Vygis1/sister/docs/ROADMAP.md

# Roadmap

What works, what doesn't yet, and what comes next, system by system. The history of how it got
here is in [CHANGELOG.md](../CHANGELOG.md).

Legend: ✅ done · 🔧 in progress · ⬜ planned

## Systems

### Nintendo 64
- ✅ Super Mario 64, Mario Kart 64 and Super Smash Bros. play
- ✅ Saves (EEPROM) on the SD card; the VI's filters selectable in the menu
- ✅ Every RDP mode the reference model has, YUV textures included
- ⬜ Full speed in every scene (the RSP and RDP's throughput)

### PlayStation
- ✅ Real BIOS, disc images, memory cards, CD audio, XA streaming, MDEC movies
- ✅ Commercial games at their own frame rates (Crash Bandicoot, Syphon Filter, Tekken 2, ...)
- ⬜ High-resolution (480i) menus, such as Gran Turismo 2's
- ⬜ The remaining ps1-tests that DuckStation passes

### DOS PC
- 🔧 Our own 486 and chipset (the first PC, on third-party ao486, was removed 2026-10-23); the bar: DOS, Doom, Rayman, TTD, Fallout
- ✅ SVGA, Sound Blaster 16 + OPL3, ATAPI CD-ROM with CD audio, mouse from the controller
- ✅ A game is one command away: `tools/pc/addgame.py`
- ⬜ A faster CPU clock (Doom's demo3 runs at 17.8 fps)

### Super Nintendo
- ✅ LoROM and HiROM up to 6 MB, save RAM on the SD card
- ⬜ Enhancement chips: DSP-1, Super FX, SA-1
- ⬜ Hi-res modes at their full 512 pixels

### Game Boy / Game Boy Color
- ✅ Both models, MBC1/3/5; cgb-acid2 pixel-exact on the board
- ✅ Battery saves on the SD card: MBC1/3/5 RAM and the MBC3 clock

### Game Boy Advance
- ✅ Pokémon Emerald with its clock; the open BIOS built in
- ✅ Saves on the SD card: SRAM, 64/128 kB flash, 512 B/8 kB EEPROM (jsmolka's save tests pass on the board)
- ⬜ OBJ mosaic, prefetch accuracy

### PC Engine
- ✅ HuCards, multitap
- ⬜ CD-ROM²

### NES · Master System · Game Gear · Mega Drive · Atari 2600
- ✅ Playable; see [CONSOLES.md](CONSOLES.md) for mapper and cartridge coverage
- ⬜ NES: more mappers (CNROM, AxROM, VRC, MMC5)

## The console

- ✅ Graphical menu composed by the FPGA, Bluetooth controllers, settings, saves on the card
- ✅ Every system checked by picture on the board (`tools/coreshots.py`)
- ✅ Two systems kept in the flash at once; switching between them takes a few seconds
- ⬜ HDMI with true differential pairs (some TVs reject the current pseudo-differential signal)

## The project

- ⬜ Release packages for every system: FPGA images and ESP32 firmware, with notices for
  third-party parts (`tools/release.sh` packages the shell, NES, Master System, Mega Drive,
  PlayStation and N64 so far)
