Vygis1/sister/docs/THIRD_PARTY.md

# Third-party components

This project is licensed under the GNU General Public License v3 ([LICENSE](../LICENSE)). The
components below come from other projects and keep their own licences, which are compatible
with it. Their original copyright notices are kept in the files.

## Other cores and tools

| Component | Where | Authors | Licence |
|---|---|---|---|
| Cult-of-GBA BIOS | `rtl/gba_bios_data.vh` | DenSinH, fleroviux | MIT ([LICENSE-gba-bios](../rtl/LICENSE-gba-bios)) |
| parallel-RDP blender tables | `rtl/n64_rdp_blut.v`, `tools/n64/n64rdp.py` | Hans-Kristian Arntzen (Themaister) | MIT |
| QR code generator | `esp32/console/qrgen.c` | Richard Moore, after Project Nayuki | MIT |
| CD-ROM drive emulation for the PC (ported) | `esp32/console/cdrom.h` | MiSTer-devel, Alexey Melnikov | GPL-3.0 |
| Nunito font (rendered) | `tools/menu/fonts/`, `esp32/console/gfx_font.h` | The Nunito Project Authors | OFL-1.1 |
| font8x8 | `rtl/osd_font.v` | Daniel Hepper | Public domain |

## Used at build time, not included

| Component | Used for | Licence |
|---|---|---|
| ESP-IDF Bluedroid, `esp_hid`, the ESP32 Bluetooth controller library | Bluetooth controllers (`pads_bluedroid.h`, docs/BLUETOOTH.md) | Apache-2.0 |
| arduino-esp32, ESP-IDF | ESP32 firmware | LGPL-2.1, Apache-2.0 |
| Xilinx MIG | DDR3 controller, generated by `tools/mig.tcl` | Xilinx licence |
| FreeDOS, HimemX, CuteMouse, LBACACHE, UDVD2, SHSUCDX | DOS disk images made by `tools/pc/addgame.py` | GPL and free licences |

## References

Behaviour was checked against these projects and documents: psx-spx and Fullsnes (nocash),
Pan Docs, the Stella Programmer's Guide, n64brew, ares, DuckStation, Mednafen and PSX_MiSTer;
and the SingleStepTests, blargg, krom and ps1-tests suites.
