Vygis1/sister/docs/hw_car.png

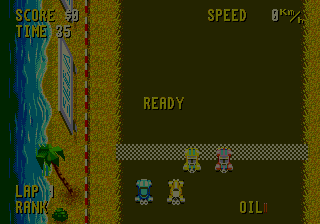
docs/hw_car.png
