Vygis1/sister/docs/images/menu_consoles.png

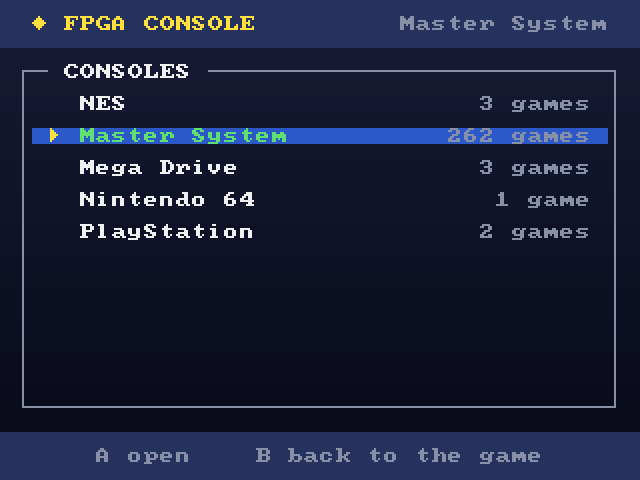
docs/images/menu_consoles.png
