Vygis1/sister/docs/images/menu_message.png

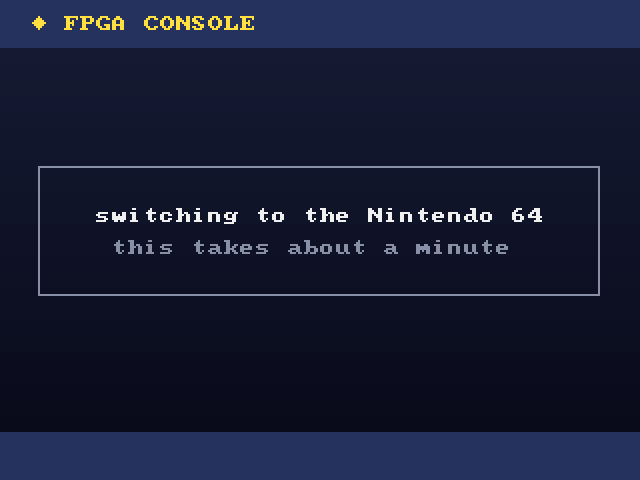
docs/images/menu_message.png
