Vygis1/sister/docs/images/menu_settings.png

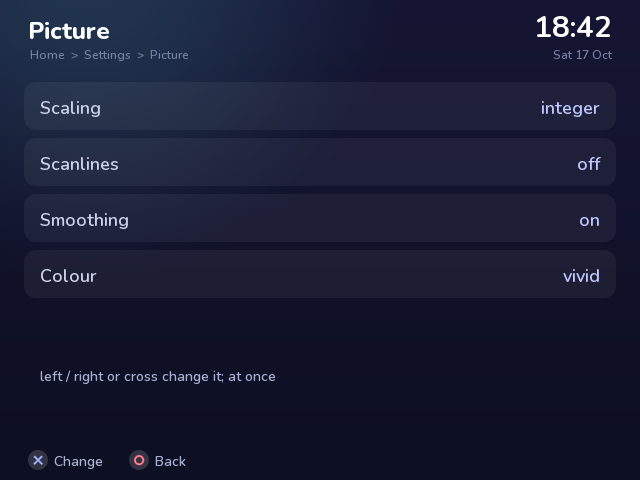
docs/images/menu_settings.png
