Vygis1/sister/docs/images/ps1_boot.png

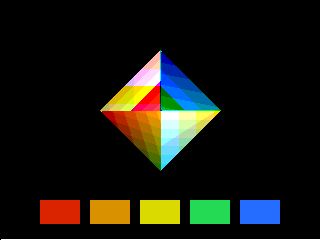
docs/images/ps1_boot.png
