Vygis1/sister/docs/images/screens/gb.png

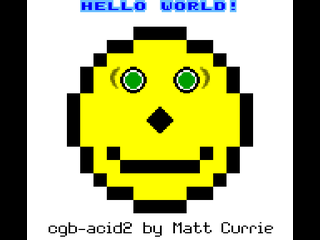
docs/images/screens/gb.png
