Vygis1/sister/docs/images/screens/gba.png

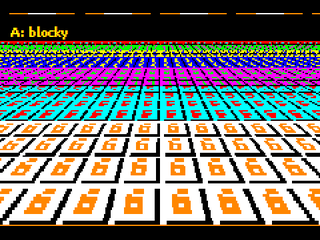
docs/images/screens/gba.png
