Vygis1/sister/docs/images/screens/gg.png

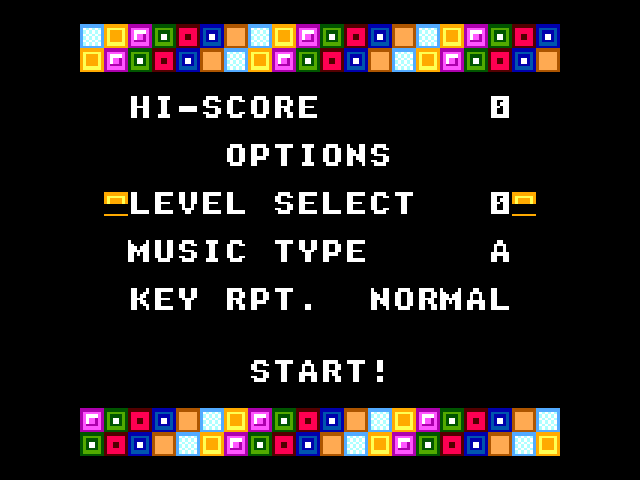
docs/images/screens/gg.png
