Vygis1/sister/docs/images/screens/md.png

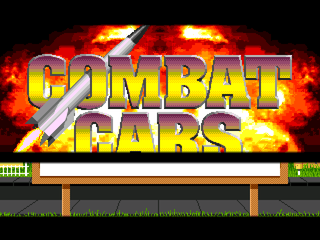
docs/images/screens/md.png
