Vygis1/sister/docs/images/screens/n64.png

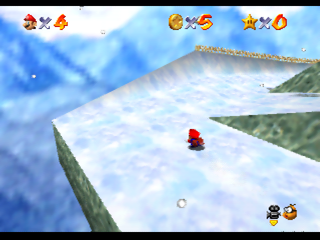
docs/images/screens/n64.png
