Vygis1/sister/docs/images/screens/nes.png

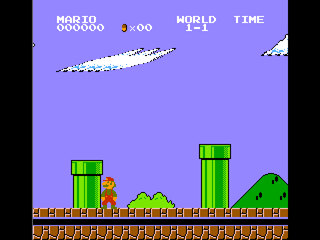
docs/images/screens/nes.png
