Vygis1/sister/docs/images/screens/pc.png

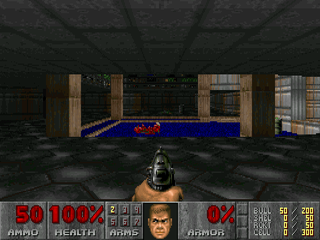
docs/images/screens/pc.png
