Vygis1/sister/docs/images/screens/pce.png

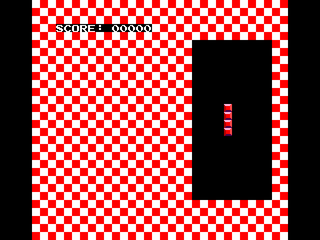
docs/images/screens/pce.png
