Vygis1/sister/docs/images/screens/ps1.png

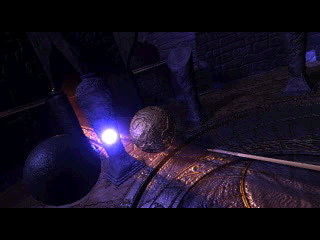
docs/images/screens/ps1.png
