Vygis1/sister/docs/images/screens/snes.png

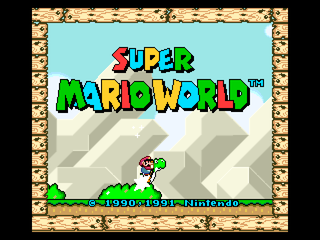
docs/images/screens/snes.png
