Vygis1/sister/docs/images/shell_switching.png

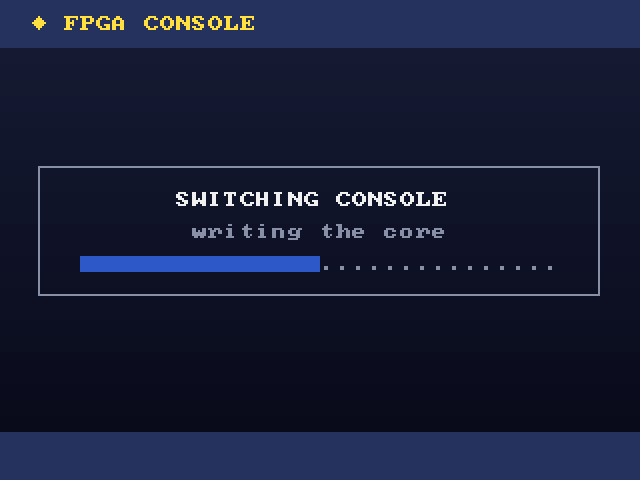
docs/images/shell_switching.png
