Vygis1/sister/hardware/cable/esp-link-harness.png

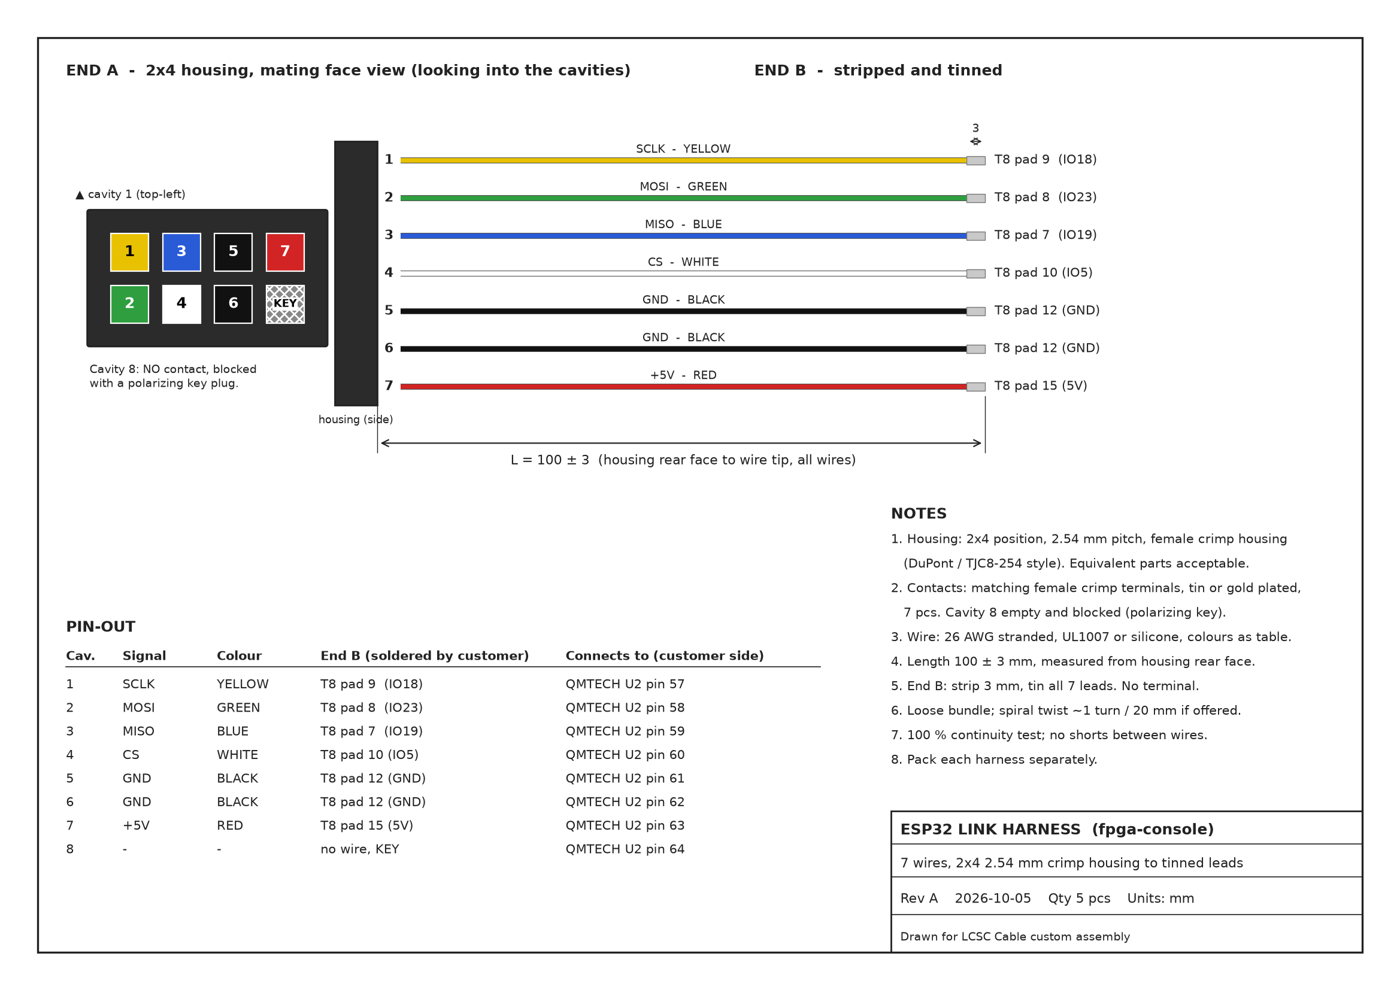
hardware/cable/esp-link-harness.png
