Vygis1/sister/hardware/enclosure/renders/closed_hdmi_side.png

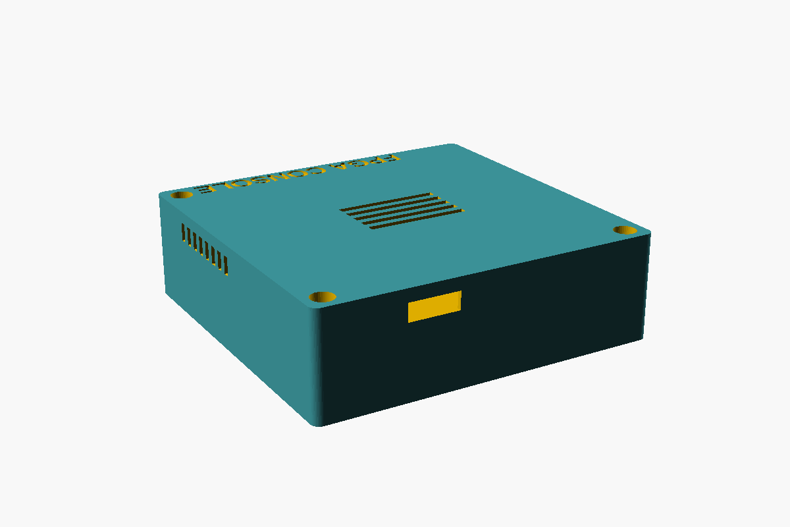
hardware/enclosure/renders/closed_hdmi_side.png
