Vygis1/sister/hardware/enclosure/stl/lid_print.stl

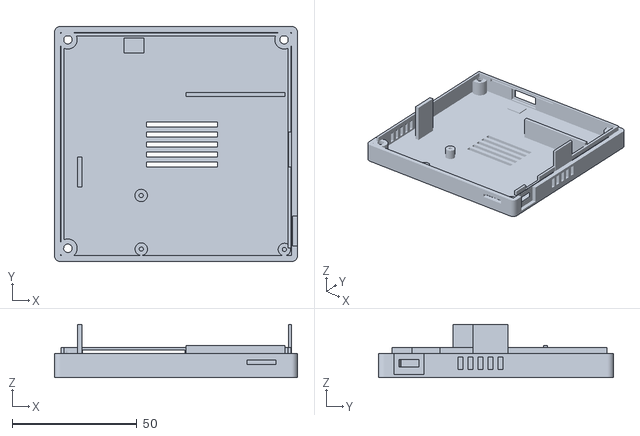
[picture p23: CAD file, 2026-10-20]
hardware/enclosure/stl/lid_print.stl
97.4 x 94.3 x 21.4
