Vygis1/sister/hardware/enclosure/stl/base_print.stl

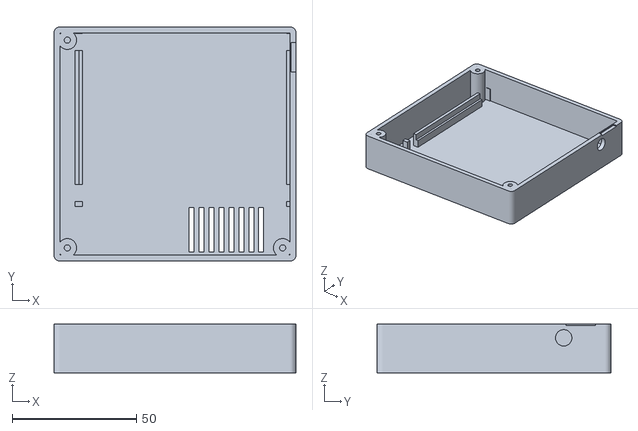
[picture p24: CAD file, 2026-10-20]
hardware/enclosure/stl/base_print.stl
97.4 x 94.3 x 19.6
