Vygis1/sister/hardware/enclosure/stl/hdmi_fit_test.stl

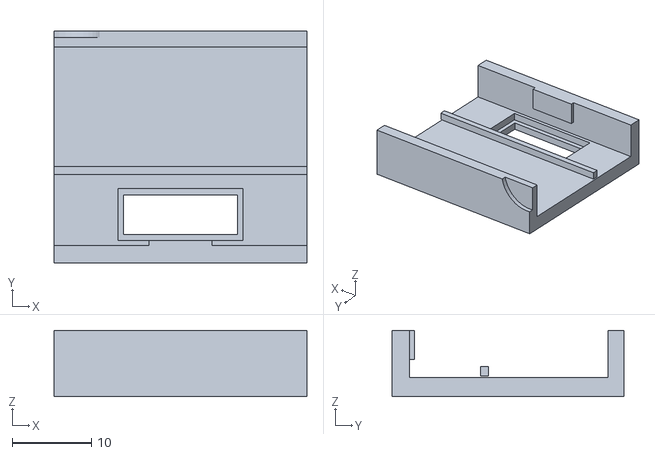
[picture p25: CAD file, 2026-10-20]
hardware/enclosure/stl/hdmi_fit_test.stl
32.0 x 29.3 x 8.40
