Vygis1/sister/hardware/cable/esp-link-harness.pdf

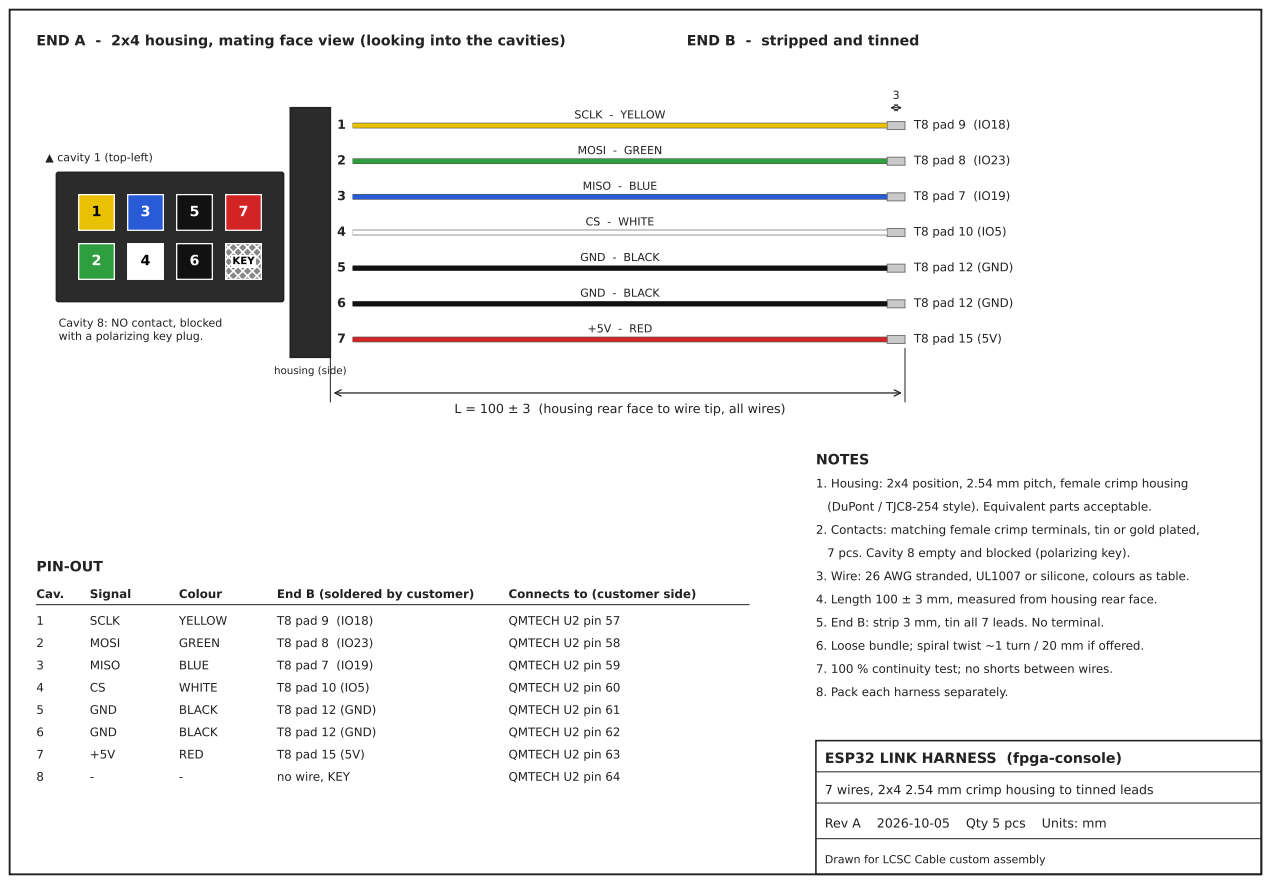
[picture p26: page 1]
Rev A; Qty 5 pcs; Units: mm; END A - 2x4 housing, mating face view (looking into the cavities); END B - stripped and tinned; KEY; SCLK - YELLOW; T8 pad 9 (IO18); MOSI - GREEN; T8 pad 8 (IO23); MISO - BLUE; T8 pad 7 (IO19); CS - WHITE; T8 pad 10 (IO5); GND - BLACK; T8 pad 12 (GND); +5V - RED; T8 pad 15 (5V); housing (side); PIN-OUT; Cav.; Signal; Colour; End B (soldered by customer); Connects to (customer side); SCLK; YELLOW; QMTECH U2 pin 57; MOSI; GREEN; QMTECH U2 pin 58; MISO; BLUE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

▲ cavity 1 (top-left)

Cavity 8: NO contact, blocked
with a polarizing key plug.

L = 100 ± 3 (housing rear face to wire tip, all wires)

1. Housing: 2x4 position, 2.54 mm pitch, female crimp housing

(DuPont / TJC8-254 style). Equivalent parts acceptable.

2. Contacts: matching female crimp terminals, tin or gold plated,

7 pcs. Cavity 8 empty and blocked (polarizing key).

3. Wire: 26 AWG stranded, UL1007 or silicone, colours as table.

4. Length 100 ± 3 mm, measured from housing rear face.

5. End B: strip 3 mm, tin all 7 leads. No terminal.
6. Loose bundle; spiral twist ~1 turn / 20 mm if offered.

7. 100 % continuity test; no shorts between wires.

8. Pack each harness separately.

ESP32 LINK HARNESS (fpga-console)

7 wires, 2x4 2.54 mm crimp housing to tinned leads

Drawn for LCSC Cable custom assembly
