Vygis1/sister/rtl/eth_top.v

//////////////////////////////////////////////////////////////////////////////////
// eth_top.v - the Ethernet endpoint, wired to real pins.
//
// The console runs from the board's own oscillator, through the MMCM (cclk,
// 1000 MHz / CLK_DIV). The ESP32 is the board's one way in (esp_bus). The network
// (NET = 1: the LAN8720 module's RMII logic, net_core, on the 50 MHz REF_CLK the
// module drives, onto the register bus through net_bridge) is not built: the board has
// no LAN module. Its pins stay in the constraints, driven low.
//
// led0  heartbeat off the board oscillator - always blinks if configured
// led1  network activity - flashes on every frame we accept or answer
//
// If led0 blinks and led1 never does, the board is alive but nothing addressed
// to us is arriving. If neither blinks, configuration failed. If led1 is solid,
// something is wrong with the activity stretcher, not the network.
//////////////////////////////////////////////////////////////////////////////////

`default_nettype none

module eth_top #(
	// Which console this image is. Set from the build -- tools/core.sh makes one
	// image per machine -- so that a core in a flash slot has the whole chip to
	// itself. Both at once is for development over JTAG.
	parameter CORE_NES = 1,
	parameter CORE_SMS = 1,
	parameter CORE_GG  = 0,     // the Game Gear (sms.v with GG): its own image, core id 'G'
	parameter CORE_MD  = 0,
	// The Mega Drive's cartridge in DDR3 rather than block RAM. Only meaningful
	// with CORE_MD, and it brings the whole memory controller in with it.
	parameter MD_DDR3  = 0,
	parameter CORE_PS1 = 0,
	parameter CORE_N64 = 0,
	parameter CORE_SNES = 0,
	parameter CORE_GB  = 0,     // the Game Boy (gb_top): its own image, the cartridge in DDR3, core id 'B'
	parameter CORE_A26 = 0,     // the Atari 2600 (a26_top): its own image, core id 'A'
	parameter CORE_PCE = 0,     // the PC Engine (pce_top): its own image, the HuCard in DDR3, core id 'E'
	parameter CORE_GBA = 0,     // the Game Boy Advance (gba_top): its own image, core id 'V'
	parameter CORE_PC  = 0,     // the PC (pc_top): its own image, core id 'C'
	// 1: the network (see the top). 0: none -- the ESP32 alone.
	parameter NET      = 0,
	// 1: the picture to the web page too, as a UDP stream (net_core's streamer, the
	// NES / Master System / Mega Drive framebuffer in regfile, the console's stream
	// registers). The picture is on HDMI; the network keeps only the register API.
	// (not with the console on its own clock: the streamer reads the console's
	// framebuffer directly, in the PHY's clock, and would need a crossing of its own)
	parameter WEBVID   = 0,
	parameter N64_DBG  = 1,      // the N64's debug window: 0 for a shipping image (n64_top DBG)
	parameter N64_ISV  = 0,      // the N64's ISViewer text capture, for n64-systemtest (n64_top ISV)
	parameter PS1_DBG  = 1,      // the PlayStation's debug hardware: 0 for a shipping image (ps1_top DBG)
	parameter JTAG_DBG = 0,      // the register bus over JTAG (jtag_axi + jtag_bus, tools/jtag.py): debug builds
	// 1: a shipping image. Nothing in it that only a PC on the network or a developer at the
	// JTAG port ever read: no logic analyser, no PC sound ring, no frame reader, no bare-CPU test
	// slot (regfile, console_top). Built with PS1_DBG = 0, N64_DBG = 0, JTAG_DBG = 0 (tools/core.sh
	// RELEASE=1). The parts that stay are the console, HDMI, the ESP32 link and the OSD.
	parameter RELEASE  = 0,
	parameter PS1_DCIDX = 8,     // the PlayStation's data cache: 2^n lines of 16 bytes (8 = 4 KB, 10 = 16 KB)
	// The console's clock: the MMCM's 1000 MHz VCO divided by this. 20 is 50 MHz,
	// what every core was written for; a core that runs faster says so in its build.
	parameter CLK_DIV  = 20
)(
	input  wire       sys_clk,       // 50 MHz onboard oscillator, ball U22
	input  wire       eth_refclk,    // 50 MHz from the LAN8720, U4 pin 47

	input  wire [1:0] eth_rxd,
	input  wire       eth_crs_dv,
	output wire [1:0] eth_txd,
	output wire       eth_tx_en,

	output wire       eth_mdc,
	inout  wire       eth_mdio,

	output wire       led0,
	output wire       led1,

	// --- the ESP32's SPI wires, on header U2 (see esp32/README.md) ----------------
	input  wire       esp_sclk,
	input  wire       esp_mosi,
	inout  wire       esp_miso,          // (let go in a quad write's data: the ESP32 drives it then)
	input  wire       esp_cs_n,
	input  wire       esp_d2,            // quad's third and fourth data wires: the ESP32's WP (GPIO 22) and
	input  wire       esp_d3,            // HD (GPIO 21), on U2 pins 12 and 11

	// --- HDMI, a bare connector breakout on header U4 pins 7-26 (boards/qmtech_a100t/
	// HEADERS.md): TMDS single-ended (+ and - driven opposite), the shields, ground,
	// CEC, DDC and hot-plug held low, the +5V pin held at 3.3 V
	output wire [2:0] hdmi_d_p,
	output wire [2:0] hdmi_d_n,
	output wire       hdmi_ck_p,
	output wire       hdmi_ck_n,
	output wire [10:0] hdmi_lo,
	output wire       hdmi_5v,

	// --- DDR3, present only in a build that uses it ---------------------------
	inout  wire [15:0] ddr3_dq,
	inout  wire [1:0]  ddr3_dqs_p,
	inout  wire [1:0]  ddr3_dqs_n,
	output wire [13:0] ddr3_addr,
	output wire [2:0]  ddr3_ba,
	output wire        ddr3_ras_n,
	output wire        ddr3_cas_n,
	output wire        ddr3_we_n,
	output wire        ddr3_reset_n,
	output wire [0:0]  ddr3_ck_p,
	output wire [0:0]  ddr3_ck_n,
	output wire [0:0]  ddr3_cke,
	// Chip select goes to a bank 16 ball the board does not connect. The memory
	// has its CS tied on the board, but the controller wants the signal, and
	// disabling it in the controller's own configuration leaves its internal
	// address multiplexer with two drivers on the same nets. Bank 16 is the
	// memory's bank and is not on the headers, so an unused pin there drives
	// nothing. One wasted ball, and a controller that is internally consistent.
	output wire [1:0]  ddr3_dm,
	output wire [0:0]  ddr3_odt
);

	// --- clocks -------------------------------------------------------------
	// cclk: the console's, from the board oscillator through the MMCM below (cclk_raw,
	// cclk_locked). (The LAN module's REF_CLK only with NET, for net_core.)
	wire cclk_raw, cclk_locked, cclk;
	BUFG bufg_con (.I(cclk_raw), .O(cclk));

	// Hold reset for 65,536 clocks after the MMCM locks.
	reg [15:0] rst_cnt = 16'd0;
	reg        rst = 1'b1;
	always @(posedge cclk) begin
		if (!cclk_locked)             begin rst_cnt <= 16'd0; rst <= 1'b1; end
		else if (rst_cnt == 16'hFFFF) rst <= 1'b0;
		else                          rst_cnt <= rst_cnt + 16'd1;
	end

	// --- heartbeat, deliberately on the other clock --------------------------
	reg [24:0] hb = 25'd0;
	always @(posedge sys_clk) hb <= hb + 1'b1;
	assign led0 = hb[24];

	// --- register bus --------------------------------------------------------
	// net_core's bus (n_*, through net_bridge to b_*) and the ESP32's (e_*), taking
	// turns onto regfile's (bus_*)
	wire [31:0] n_addr, n_wdata, n_rdata, b_addr, b_wdata, e_addr, e_wdata, bus_rdata;
	wire        n_we, n_re, b_we, b_re, b_ack, e_we, e_re, bus_ack, n_ack, e_ack;
	wire [1:0]  bus_err, n_err;
	wire        n_frd;
	wire        rx_frame, tx_frame;
	wire        rf_mdc, rf_mdio_o, rf_mdio_oe;     // the register file's MDIO master (NET)

	// the frame streamer's settings come from the console's registers
	wire        stream_en, stream_ready, stream_done_tog;
	wire [15:0] stream_port;
	wire [31:0] stream_base;
	wire [17:0] stream_words;
	wire [15:0] stream_rowlen, stream_stride;
	wire        stream_direct, stream_fvalid, stream_frd;
	wire [31:0] stream_fdata;
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
