Vygis1/sister/rtl/pce_top.v

`timescale 1ns / 1ps
//////////////////////////////////////////////////////////////////////////////////
// pce_top.v - a NEC PC Engine / TurboGrafx-16: the HuC6280 with its sound and timer, the
// HuC6270 video controller, the HuC6260 colour encoder, the pad port, a HuCard.
//
// --- the physical map (the processor's 21-bit address) ------------------------------------
//
//   $000000-$0FFFFF   the HuCard, through the cartridge port (DDR3 behind a cache outside)
//   $1F0000-$1F1FFF   8 kB of work RAM (mirrored through $1F7FFF)
//   $1FE000-$1FE3FF   VDC     $1FE400-$1FE7FF   VCE     $1FE800-$1FEBFF   PSG
//   $1FEC00-$1FEFFF   timer   $1FF000-$1FF3FF   pads    $1FF400-$1FF7FF   interrupt control
//   $1FF800-$1FFBFF   CD-ROM: nobody there, reads $FF
//
// A HuCard of 384 or 768 kB is laid out as the chip sees those: the first 256 (512) kB, then
// the rest twice; other sizes repeat through their power of two. The loader says the size.
//
// --- clocks ------------------------------------------------------------------------------------
//
// The processor's 7.16 MHz is an enable from the system clock; the chip's low speed is the
// processor's own business (four of them a cycle). A cartridge byte not in the cache holds
// the enable until it comes. The VCE makes the 21.48 MHz master enable and the dot clock
// from the same system clock; the PSG its 3.58 MHz.
//
// --- the pad port --------------------------------------------------------------------------------
//
// $1FF000: a write sets SEL (bit 0) and CLR (bit 1); a read gives four buttons active low in
// the low nibble -- SEL high: left, down, right, up; SEL low: run, select, II, I (the pad's
// 74LS157: select 1 = the directions, as MAME's pce_ctrl/joypad2.cpp wires it) -- and 1011
// above. A five-port multitap sits on the port as the games expect: CLR resets it to the
// first pad and SEL rising moves it on. joy1 / joy2 are {left, down, right, up, run, select,
// II, I}, 1 = pressed.
//
// The timer: a 7-bit counter stepped every 1024 processor clocks, reloaded from $0C00 when
// it passes 0 and raising its interrupt; $0C01 bit 0 runs it. Interrupts: $1402 masks
// (bit 0 IRQ2, 1 IRQ1 -- the VDC --, 2 the timer; 1 = off), $1403 reads them (same bits) and a
// write to it acknowledges the timer.
//////////////////////////////////////////////////////////////////////////////////

`default_nettype none
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
