Vygis1/sister/(commit log)

2026-09-24 QMTECH Artix-7 console: NES, Master System, Mega Drive and PlayStation cores
    A PlayStation on an XC7A100T: R3000A with instruction and data caches, a
    hardware-checked GTE, a two-pixels-a-clock rasteriser over VRAM in DDR3, a
    CD-ROM drive model fed sectors over SPI from an ESP32, and the frame pushed
    to a browser over UDP. Plus the earlier NES, Master System and Mega Drive
    cores and the shell that installs one into the flash slot.
    First commit of a tree that had no version control, which cost real time:
    "did my change cause this?" could only be answered by reconstructing the old
    code by hand, and a measurement baseline was lost to an overwrite.
    Not included, deliberately: build products, bi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
2026-09-27 PS1: sound, and the picture streamed without a frame buffer
    Sound (rtl/ps1_spu.v, replacing the register stub):
    - 24 ADPCM voices: lazy per-voice decode with a prefetched next block
    (one DDR3 line each), Gaussian interpolation, the full ADSR envelope,
    pitch modulation, noise, loop flags / ENDX, KON/KOFF, IRQ9.
    - Reverb with the 39-tap resampler; the top 128 KB of SPU RAM is on-chip
    block RAM (ps1_spu_ram.v), single-homed, the rest in DDR3 (port 5).
    - Transfers through a FIFO and line write-combiner; DMA channel 4 real.
    - tools/spu_ref.py + sim/tb_ps1_spu.v: bit-exact against a Python model
    over 2,500 ticks, reverb exercised. On the board the boot chime and
    Crash's music match DuckS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
2026-09-28 Sound: a server thread drains the board's ring; the page polls memory, 70 ms margin
    The page read the audio ring over the register link on every poll, under
    the one bus lock, so a lost packet cost a 0.25 s timeout (x3) and the
    player needed a 180 ms margin on top of a 60 ms poll. AudioPump reads the
    ring every ~5 ms on its own socket with a 20 ms timeout and answers the
    page from memory (1.5 ms median); the page polls every 20 ms with a 70 ms
    margin and never queues more than 160 ms.
2026-09-28 PS1: the disc from the PC over Ethernet, a frame event profiler, dma_relax
    host_cd.v takes 2352-byte sectors written by the server's HostDisc thread
    (ctrl 0x4000 window, commit at 0x12C, ownership at 0x130), for when the
    ESP32's SD card does not answer. ctrl 0x120/0x124 read a 64-entry ring of
    flip / DMA2 / GPU idle / vsync events, reported by tools/ps1frameevents.py.
    ctrl 0xEC bit 14 lets the CPU run from cache while a DMA holds the bus.
2026-09-28 PS1: 64 kB CPU cache in block RAM, and the CPU on every clock by default
    In N. Sanity Beach every frame took three vsyncs (20 fps) where the console
    takes two. The processor was the limit: 35 ms of work a frame against 33.3.
    ps1_cache gets a BRAM mode: lines and tags in block RAM (16 tiles for
    64 kB), read on the same edges the LUT-RAM arrays were, so a hit is still
    one clock; a fill re-reads the line in S_LOOK. The CPU's cache uses it at
    IDXBITS 12. CPU busy share of a frame fell from 86% to 70%, not enough on
    its own.
    ctrl 0xEC bit 12 is inverted: clear now runs the CPU on every 50 MHz clock
    (timers, video, sound keep the console's 33.8688 MHz), set holds it to the
    console's pace. This C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
2026-09-29 Server: remember which core is running instead of asking on every picture
    Every /api/vid/frame read the core register first. One lost reply anywhere
    latches the board as gone for a moment, the read then failed, the route fell
    through to the RGB332 path and answered 503. With the game at a steady 30 the
    page got 15 pictures a second with 250-550 ms holes; now 34 a second, no gap
    over 100 ms.
2026-09-29 PS1: memory card, and an empty drive that says so
    The card is in slot 1 (ps1_sio.v): read, write and get-ID answered byte for
    byte as DuckStation's MemoryCard::Transfer does. Its 128 kB are in DDR3 at
    9 MB, a sector at a time through a buffer and the host's arbiter port; stored
    sectors are queued (ctrl 0x138) and the server copies each into a .mcr file
    (saves/card1.mcr, PS1_CARD). The file is loaded with the BIOS. Checked by
    tb_ps1_mcard (with two deliberate faults caught); on the board Crash lists a
    save from the file and a delete in the BIOS card manager changes exactly its
    directory frame in the file.
    With no disc the drive reported its motor running and the BIOS waited for
    ever; it now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
2026-09-29 Prepare the repository for publishing
    A README that describes the project (the old one, the board's bring-up
    notes, is docs/BOARD.md), requirements.txt, and settings for one machine in
    local.env (see local.env.example), read by fpgalink.py: FPGA_HOST, PS1_BIOS,
    PS1_CARD, ESP_HOST. The tools find the repository from their own location
    instead of C:/fpga, and take the board's address from fpgalink.DEFAULT_HOST.
    Personal paths are gone from the docs; crash dumps, root screenshots, card
    images and local.env are ignored.
2026-09-29 ESP32 disc: read the card on its own core, faster than a real drive
    The SD card was never broken -- it answered again after a restart of the
    ESP32, and `cardtest <lba> <n> [MHz]` (new) read 1.2 MB of the image with a
    CRC matching the PC's copy. What failed was the rate: reading a sector (4 ms
    at 8 MHz) and sending it to the FPGA (3.8 ms at 5 MHz) one after the other
    gave 128 sectors a second, slower than the real drive's 150. With the CPU on
    every clock Crash crashed into the BIOS's exception loop in its intro on every
    SD boot; at console pace, or fed from the PC, it did not.
    A reader task on core 1 now keeps a ring of 128 sectors ahead of the drive
    while the drive task on core 0 only sends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
2026-09-30 ESP32 page: the disc, machine names, and a status call that answers
    /api/state listed /roms (272 games) and /cores off the card on every call,
    8.5 seconds each, so the page looked hung. The listings are cached, scanned
    once in the background at boot and again after an upload or a disc fetch.
    The page names the machine (Shell, PlayStation) instead of "core 80", no
    longer says a core needs a power cycle to leave (PROGRAM_B is wired and the
    button below does it), and gains a Disc section: what is in the drive, the
    images in /discs to pick from, and Eject. Installing a core from the card
    asks first, since one tap rewrites the flash.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
2026-09-30 Page: a PlayStation panel, the whole pad, and no clutter over the game
    - The console view hides the developer tabs; they showed under the game.
    - "Drop a cartridge here" clears when a picture arrives; it waited for the
    NES frame counter, which the PlayStation does not have, and sat over the
    running game.
    - For the PlayStation the cartridge slot gives way to a panel with the BIOS,
    the disc (from this PC or the SD card, with a switch) and the memory card
    (/api/ps1/media).
    - The pad has every button a modern controller has: Square, Triangle, L1/R1,
    L2/R2 reach the PlayStation (they were missing; Crash spins on Square), and
    each machine's buttons are labelled as that machine names th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
2026-09-30 Release 0.1.0 preparation: VERSION, CHANGELOG, tools/release.sh
    VERSION is reported by /api/ident and shown in the page header.
    tools/release.sh packages dist/fpga-console-<VERSION>/: the five core images,
    the ESP32 firmware, a source archive of the commit and SHA-256 sums. It
    refuses uncommitted changes and images older than the RTL. The README gains
    the keyboard defaults and a note on releases.
2026-09-30 Sound for the NES and Master System; a disc swap that cannot empty the drive
    The synth's ring records either its own voices or the console's sound
    (SYN_CTRL bit 1), nothing ever chose the console, and it resets to the synth:
    the NES, Master System and Mega Drive played silence on the page. Loading a
    cartridge now selects the console; playing the synth's keyboard selects the
    synth; the on/off switch keeps the source. On the board: Super Mario Bros.
    and Alex Kidd play sound.
    After restoring the BIOS the server told the ESP32 to put DISC_ON_CARD back,
    whose default had become a file not on the card. The ESP32 stopped the drive
    before finding that out and left it empty, and the BIOS sat at its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
2026-09-30 README: the project in depth
    What it is, the hardware, how the board, the PC and the ESP32 talk, each
    console, the PlayStation subsystem by subsystem, the infrastructure, building
    and running, using it, development, layout, status and known issues. No
    licence yet: all rights reserved.
2026-10-02 N64: the plan, a VR4300 model, and the first RTL CPU
    - docs/N64.md: the rule on sources (our own code; ares, n64brew, krom's
    tests and libdragon as references), the measured fit (an N64 is 72% of
    the XC7A100T's LUTs), the memory map and the order of work.
    - tools/n64model.py: the VR4300 (MIPS III, 64-bit, big-endian) with COP0,
    the TLB and exceptions, following ares instruction for instruction, and
    enough of the machine for test ROMs; boots without a PIF ROM.
    - rtl/vr4300.v: a five-stage pipeline with an iterative multiply/divide.
    No TLB lookup, FPU or caches yet.
    - sim/tb_vr4300.v + tools/n64sim.py: the RTL against the model,
    instruction by instruction and all of RDRAM. krom's A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
2026-10-02 N64: the CPU passes krom's tests on the board
    - rtl/vr4300.v: the five-stage MIPS III pipeline, now 62.5 MHz-clean at
    synthesis (the load masks without subtractors; the multiply/divide start
    off a register; the multiplier's product registered before it is added).
    In simulation: every integer and exception test identical to the model.
    - rtl/n64_top.v: the CPU with RDRAM and the cartridge in DDR3, our own boot
    ROM (tools/n64bootrom.py: copies the game, leaves IPL3's state), SP
    memory, the MI and the VI's timing. A new fetch supersedes an abandoned
    one; the fill no longer loses a line's first word.
    - The shell: CORE_N64, console 4, ./tools/core.sh n64; the server loads
    N64 ROMs (.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
2026-10-02 N64: PI DMA, and a forwarding fix it exposed
    - n64_top.v: the Peripheral Interface's DMA, cartridge to RDRAM and back,
    as ares does it (dma.cpp): 128-byte blocks within 2 kB rows, the first
    block written byte by byte when misaligned, RDRAM's address rounded up
    to 8 after, the length register reading 127 less the misalignment.
    PI_STATUS reports busy and the interrupt; the end raises MI's PI bit
    and drops the caches' lines it may have overwritten.
    - vr4300.v: an E stage held by a stall lost an operand that was being
    forwarded from the instruction leaving W -- the register file was read
    long before. E now keeps what is forwarded while it waits. Found by
    krom's DMA test storing t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
2026-10-02 N64: the FPU
    - tools/n64fpu.py: COP1 for the model, following ares (ISC). Every result
    is worked out exactly as a fraction and rounded in FCR31's mode, so all
    four modes and every flag are the same on any machine; where ares leans
    on the x86 it runs on, this does what x86 does (tininess after rounding,
    underflow only when inexact). The VR4300's limits: subnormal operands
    and results, quiet NaNs (quiet bit clear, the old MIPS way) and
    out-of-range conversions trap as unimplemented, unless FS flushes. The
    FR=0 register pairing as ares models it, odd corners included.
    krom's CP1 tests: 376 of 377 checks pass (the one left is the timing
    test), and COP1FullMode prints exactly th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
2026-10-03 N64: the RSP, an RDP stand-in, the RDP model, and Super Mario 64 booting on the board
    - RSP in RTL (n64_rsp.v): scalar unit, vector unit, DMA, COP0; all 56 of
    krom's RSP tests agree with the model (tools/n64rsp.py) run by run.
    - RDP stand-in (n64_rdp.v): the registers and the command walk, no drawing.
    CURRENT stays within END (SM64's microcode cuts a texture rectangle across
    END and waits for the RDP to leave the space it writes next), and the
    cached line is dropped at every END.
    - RDP model (tools/n64rdp.py), derived from parallel-RDP (MIT): krom's RDP
    tests match the hardware screenshots (mean 95.7%), and SM64 draws its
    title and Mario's face in the model.
    - TLB, timing work on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
2026-10-03 N64: SM64 runs on the board (logic and sound); the RDP in RTL, untextured
    Super Mario 64 now runs continuously on the board: 890+ frames, 22,000+ RSP
    tasks, audio playing (recorded through the page's stream). It stalled after
    140-180 frames, for these reasons in turn:
    - An RSP MTC0 on the clock the CPU wrote an SP register was dropped; the
    RDP had the same flaw. Both now hold the RSP's write a clock.
    - An interrupt raised on the clock the CPU cleared it was lost (the clear
    came last): set now wins.
    - DMA BUSY dropped for one clock between a finished DMA and the queued one,
    so a microcode polling BUSY parsed a command chunk before it had come.
    - And the last: a speed race. The model (to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
2026-10-03 N64: the RDP draws textures; SM64 plays on the board with our RDP
    The RDP in RTL (n64_rdp2) now textures: TMEM loads, the sampler, bilinear,
    perspective, LOD, TLUT. 61 of krom's 67 1-cycle textured tests match the
    model; the rest are YUV (4) and copy mode (2), neither built yet.
    n64_rdp2 replaces the stand-in on the board (a write port of its own; acks
    pulse each clock). Super Mario 64 runs through the face, file select and
    the castle intro into the castle grounds, where Mario walks.
    Also: a log of RDRAM writes below 0x400 in the debug window (39-43),
    tools/n64shot.py (the board's picture as a PNG), and snapshot resume and a
    timed pad schedule in tools/n64rdpsim.py.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
2026-10-03 N64: the RDP as a pipeline; span buffers; faster RSP loads and stores
    The RDP draws a pixel a clock (n64_rdp_pix.v, the stages the RDP has:
    shade, perspective, sampler, combiner, depth, blender, store), fed spans
    by the rasteriser with their colour and depth lines fetched ahead into
    a two-slot span buffer through a pipelined read path in n64_top. The
    sampler is pipelined (n64_rdp_texp.v) with TMEM split into halves so a
    texel's second read has its own port. Row setup works all eight
    attributes at once; FILL writes a line at a time. On the bench, SM64's
    intro letter frame takes 255k RDP clocks instead of 952k, with the same
    output; krom tests checked so far match the model.
    On the board: a b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
2026-10-03 N64: the RDP runs SM64 on the board; read-ahead; a new list waits for the old
    - A new DP buffer (START, then END) set while the last one is still being walked now
    waits for the walk to reach the old END. Taken at once it skipped the old list's
    tail and read a command's rest from the new buffer: a garbage SET_COLOR_IMAGE, the
    RDP drawing over SM64's memory (a thread's stack), a TLB fault.
    - RDP reads are capped at 4 outstanding: ddr3_mem drops read data that MIG returns
    while its return queue looks full (pessimistic across the clock crossing).
    - n64_rdp_stream.v: a 4-line read-ahead for the command walk and TMEM loads on the
    pipelined port it shares with the raster (each read's owne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
2026-10-04 N64: the RSP 2.5x faster; its DMA reads through a read-ahead
    The RSP (krom's 56 RSP tests and 40 SM64 tasks all agree with the model):
    - the next instruction is taken straight from an instruction's last state (no fetch
    clock): GPR and vector register writes forwarded to the instruction a clock behind;
    - a vector op's second clock (accumulator, flags, write-back) runs beside the next
    instruction, which waits only for that op's result (IMEM's output held meanwhile);
    - fast loads and stores issue their DMEM access from R_EX; LBV/LSV/LLV and their stores
    in one doubleword; the byte-serial vector loads pipelined a byte a clock;
    - VRCP/VRSQ's table index from registers in its own clock (a 28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
2026-10-04 N64: the read-ahead counts every acknowledged read; a randomized bench for it
    A read taken by the arbiter just as a flush stopped the requests was acknowledged after
    q_valid had fallen, and went uncounted: its line came back as the next one's. On the
    board SM64 then got a corrupt display list (a fill at address 0, a CPU fault) after four
    frames. q_ready alone now counts (it only ever answers this unit's reads).
    sim/tb_n64_rdp_stream.v: random runs, jumps and flushes against an in-order memory with
    random delays and an arbiter like n64_top's; every line handed over is checked. It finds
    the old fault in a few dozen lines; the fix passes 37k lines and 530 flushes.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
2026-10-04 N64: tagged reads, deeper read queues, a vector unit a third the size
    - Every DDR3 read is queued with its owner (RDP, RSP read-ahead, or the one
    single read), so the CPU no longer waits for pipelined reads to drain.
    SM64's CPU: 15.8 -> 19.5 M instructions/s.
    - ddr3_mem's return queue is 32 deep (it is distributed RAM either way), so
    up to 12 reads may be out; the read-aheads hold 8 lines in LUT RAM. An RSP
    DMA takes 103 clocks, was 123.
    - The RSP's lanes share one 48-bit accumulator adder and one 18-bit adder
    per lane, base and addend chosen by the opcode, as the real RSP is built.
    It had a 50-bit adder and clamp per opcode per lane: ~11k LUTs. krom's 56
    RSP tests and 120 SM64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
2026-10-04 N64: more RSP vector loads/stores on the fast path; the RSP read-ahead snoops
    - LPV/LUV (8-aligned, element 0), LQV from inside its quadword (element 0,
    the quadword read at once from the banks) and SPV/SUV (8-aligned, element 0)
    no longer walk a byte a clock: SM64's graphics microcode used them ~50k
    times in the model's run. krom's 56 RSP tests and 120 SM64 tasks agree.
    - The RSP's read-ahead is no longer emptied at every DMA's start (every DMA
    paid a DDR3 round trip, even one going on where the last left off): every
    write to RDRAM, whoever's, is snooped, and only a write into the lines it
    holds or has asked for empties it. tb_n64_rdp_stream now lands writes near
    the client an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
2026-10-04 N64: scalar loads beside the next instruction; 64 kB D-cache
    - The RSP's scalar registers have a second write port: a fast scalar load's
    data is written beside the next instruction (sl_pend), which waits a clock
    only if it names the register. The 120 SM64 tasks: CPI 1.03 -> 1.01 on the
    bench; krom's 56 RSP tests and the 120 tasks agree with the model.
    - The D-cache is 64 kB (8x the chip's); a CACHE op by index covers the 8
    lines sharing its index. (The data fills did not fall: 285k -> 283k a
    second. The cache writes through without allocating; being looked at.)
    Board, SM64 (window timed by VI): 20.1 drawn frames/s; RSP busy 78% (graphics
    CPI 1.09, audio 1.02), CPU 29.3 M instructi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
2026-10-04 N64: the D-cache is kept equal to memory; its CACHE ops do nothing
    SM64 writes back and invalidates the whole D-cache by index before every RSP
    task (osWritebackDCacheAll), so the 64 kB cache started cold a hundred times
    a second: the board filled 9.7 lines a 1000 instructions where the model,
    keeping its lines, filled 1.8.
    The D-cache writes through, so it can simply be kept equal to memory: a CPU
    store updates a line it holds (through the uncached window too), and a write
    by anyone else (the RSP's DMA, the RDP, the PI, the SI) drops the line it
    hits (snooped, tag checked). Its CACHE ops then have nothing to do. (A
    program that relied on reading a stale line after a DMA would see the new
    d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
2026-10-04 HDMI out of the FPGA: a bare connector breakout on header U4
    640x480 at 60 Hz over TMDS, from a bare HDMI socket breakout plugged straight
    onto header U4 pins 7-26, turned so the socket faces outward (HDMI pin k on U4
    pin 27-k). Shown working on a TV with the test image.
    - hdmi_tmds.v: one channel's DVI 1.0 encoder (transition minimising, DC
    balance, control tokens).
    - hdmi_tx.v: the 640x480 timing, three encoders, the serialisers. The QMTECH
    headers pair their balls across the two rows and the breakout puts a pair's
    + and - in one row, so no pair lands on a true P/N pair: each wire is its own
    LVCMOS33 output, + and - driven opposite (PSEUDO). A cascaded 10:1 OSERDESE2
    needs its p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
2026-10-04 The NES on HDMI; a PC gamepad as its joypad; a USB-host pad test for the ESP32
    - nes_hdmi.v: the NES's picture for HDMI -- a 256x240 frame of colour indices
    in block RAM, written as the PPU draws, read in the pixel clock doubled
    (512x480) and centred, through the palette at 24 bits (nes_palette888.v, the
    same 64 colours as nes_palette.v, generated from its table). console_top picks
    the running core's picture for HDMI.
    - eth_top: a build without DDR3 (the NES) gets an MMCM of its own for HDMI;
    the clock buffers and hdmi_tx are shared by every build.
    - pc/pad.py: any controller SDL knows (PS5, PS4, Xbox), plugged into the PC,
    as NES joypad 1 through the server.
    - esp32/usbpad: the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
2026-10-04 HDMI audio: 48 kHz stereo L-PCM in data islands
    hdmi_tx (AUDIO = 1) is HDMI rather than DVI now: one data island in each line's
    blanking (an 8-clock preamble at 644, guard bands, two 32-clock packets), and the
    picture's own preamble and guard band before each active line. Packet A carries
    the audio samples waiting (up to 4) or is null; packet B is the AVI InfoFrame on
    line 0 (640x480, VIC 1, RGB), the Audio InfoFrame on line 1 (2 channels), Audio
    Clock Regeneration otherwise (N 6144, CTS 25000 -- exact at 25.000 MHz and
    48 kHz). TERC4 coding, BCH ECC per packet part, channel 0 = {1, header bit,
    VSYNC, HSYNC}: from the HDMI 1.4 data island structure, checked against
    hdl-util/hdmi.
    regfile lo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
2026-10-04 NES sound right on HDMI: five APU bugs, and the 48 kHz path paced on the pixel clock
    The APU:
    - the frame sequencer counted the published steps (APU cycles) as CPU cycles,
    so every note's length and decay ran twice as fast -- "bits of music too short"
    - a negated sweep target muted pulse 1 (games write $08 to keep low notes)
    - the noise period table is CPU cycles: was an octave low; DMC one cycle long
    - clocked through OAM DMA as the real chip is (was a 60 Hz pitch wobble)
    - the NES dot clock is exactly 5,369,318 Hz (was 50/9 MHz, 3.5% sharp and fast)
    HDMI audio: the console's sample was zero-extended after XOR 0x8000 (a jump of
    the whole range at every crossing); DC-blocked, averaged ove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
2026-10-04 The menu on the TV: the ESP32 drives the console image, the shell has a picture
    FPGA:
    - esp_bus.v: the ESP32 as a second master on the register bus (bus write /
    bus read frames over its SPI wires), bus_arb.v sharing it with net_core
    - osd.v: 40x30 text over the HDMI picture (font8x8_basic, public domain,
    tools/gen_osd_font.py), on regfile page 0x0007
    - frame_hdmi.v: the Master System's (6-bit) and Mega Drive's (9-bit) own
    HDMI frames, doubled and centred
    - icap_reboot.v: SYS 0x0014 = 0xB0070000 restarts into the shell
    - the halt bit pauses the NES and Master System (the menu pauses the game)
    - the shell gets HDMI: shell_screen.v shows the install's progress
    ESP32 (esp32/console/menu.h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
2026-10-04 PlayStation and N64 toward HDMI and the menu; stereo; Bluetooth pads for the T8
    - hdmi_tx FS441: 44.1 kHz audio (N 7056 / CTS 31250, exact at 25 MHz) for the
    PlayStation; stereo samples straight from the PS1 SPU / N64 AI, and the Mega
    Drive's two channels at 48 kHz, instead of the mono mix
    - the PlayStation's picture: fb_ddr captures every frame and fetches the line
    HDMI wants next into n64_vid (PS1=1, RGB555) -- a 38-block-RAM frame pushed
    the CD drive's buffers into 10k LUTs of distributed RAM; tb_ps1_hdmi checks
    every pixel through a DDR3 model shared with the capture
    - the PS1 image shares the ESP32's wires: esp_bus and cd_feed both listen, the
    command byte picks who answers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
2026-10-05 Menu: PlayStation memory card and N64 EEPROM saves on the SD card; N64 controller 1 plugged in
    The PS1's card 1 is /saves/card1.mcr (created formatted when missing), put in
    with the BIOS, every stored sector copied back from DDR3 through the line
    window as pc/server.py does. The N64 load sets N64_CFG as the server does --
    without it SM64 had no controller -- with the EEPROM size from the game-ID
    table (pc/n64_saves.py, incl. its SM64 / Wave Race special cases); the EEPROM
    goes to /saves/n64/<id> <title>.eep every 20 s when changed and before a
    switch.
2026-10-05 Menu: a Bluetooth pad's PS / Home button opens and closes it, on every console
    Start+Select only works where the machine's pad has a Select (the menu reads
    the pad back in the running machine's order); the Mega Drive's and the N64's
    layouts have none on a Bluetooth pad.
2026-10-05 esp32/README: the menu, the card's layout, the T8 and its Bluetooth pads
2026-10-05 HDMI audio at 44.1 kHz for the N64 as for the PlayStation; narrow doubled pictures centred
    The N64 core hands out 44.1 kHz samples; re-timed onto 48 kHz in hdmi_tx they
    sounded badly broken on the TV while the same samples recorded on the PC were
    clean. n64_vid centres a doubled picture narrower than 320 (a PlayStation game
    in a 256/512-wide mode sat at the left); tb_ps1_hdmi checks 256 wide.
2026-10-05 HDMI: whole frames only -- the PlayStation's frame double-buffered, the N64's origin per frame
    fb_ddr keeps two frames for HDMI: the capture writes the one not on screen, a
    finished capture waits until HDMI starts its next frame, and no capture starts
    meanwhile -- one frame written while it was read showed pixels of two frames
    (the user saw a blink's eye pixels wrong for a frame). tb_ps1_hdmi now gives
    each capture its own picture, captures five times faster than HDMI shows, and
    requires every pixel of each shown frame to come from one capture.
    The N64's HDMI fetcher took VI_ORIGIN fresh for every line; a flip in the
    middle of an HDMI frame showed the rest from the other buffer. It is taken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
2026-10-05 Polish: checked game loads, the Mega Drive's stereo filtered, N64 DAC ticks kept, a nicer menu and shell
    - regfile keeps a checksum of every cartridge write with its address (SYS
    0x0018); the ESP32 sums what it sent and sends a chunk again when they differ
    -- bit flips on its wire left corrupted tiles in NES and Mega Drive title and
    demo screens. esp_bus also gets a block read (0x42).
    - aud_filter.v: the mono path's low-pass / DC block / per-sample average as a
    module, two of them for the Mega Drive's stereo (its FM chip time-multiplexes
    the channels: sampled directly it crackled).
    - n64_top: DAC ticks that find the last sample still waiting for its line are
    owed, not merged (SM6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
2026-10-05 menu_preview: cut.h is generated
2026-10-05 Mega Drive: sprites late in a long list were not drawn -- a sprite attribute cache and a faster engine
    The engine walked the whole list for every line, two VRAM reads an entry in the
    slots the planes left, a pixel a clock on the pixel clock; what it had not
    reached when the line ended was dropped. A game's character screens put the eyes
    and mouths on as extra sprites late in the list: they vanished for frames.
    - the sprite attribute cache, as the real chip has: each entry's Y and
    size/link kept inside, updated by the VRAM writes that land on the table
    where it is -- walking the list is a clock an entry, no VRAM
    - the render port reads on every clock: the planes' on the pixel clock (thei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
2026-10-05 Mega Drive sound: the Z80 gets its vertical-blank interrupt, and its RAM read survives a bus request
    Battletoads was silent (traced in sim/tb_md_z80trace.v):
    - the Z80's INT was tied off. The VDP interrupts it at the vertical blank, a
    line long, as the real chip does (md_vdp zint); drivers built on IM 1, like
    Battletoads', sat in JR $ forever without it
    - the Z80's RAM shared one port with the 68000, its address switched to the
    68000's while the Z80 was stopped: a Z80 stopped in the middle of a read came
    back to the 68000's byte. Battletoads' driver, stopped in the operand of its
    JR $, jumped into its handler, returned off an empty stack (00 F3 out of
    $1FFF and its mirror of $000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
2026-10-05 menu: a serial line per button edge (what the menu saw, open or not, level, item)
2026-10-05 NES: a $2007 read of tile ROM took its byte from the name table half the time
    nes.v chose between tile ROM and name table on the current VRAM address, but
    both memories answer a clock after they are addressed, and a $2007 read drives
    the bus for one clock only: by the answer the address was the rendering fetch's
    again, and while that pointed at a name table or attribute byte the read came
    back from the name table. Super Mario Bros. copies its title screen out of tile
    ROM through $2007; it drew the title as garbage and kept the garbage in its
    status bar through the demo ("WO LD 1 1", "TI E", level columns over it).
    The select is registered with the data now. sim/tb_nes_smb.v runs SMB with th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
2026-10-05 tools/: per-console folders; source stamps blind to comments
    The 116 scripts in one flat folder are sorted: tools/ keeps what builds,
    simulates, releases and talks to the board; tools/{nes,sms,md,ps1,n64}/ hold
    each console's reference models, test-program generators, test runners and
    board debugging. tools/README.md says what is where.
    - every mention of a moved script (docs, benches, RTL comments, scripts) names
    its new path; paths a script climbs from its own folder climb one more
    - mipsasm.py stays in tools/ (the PlayStation's and the N64's test programs both
    use it); the scripts that import it, and padpress.py (n64dbg's accessor), add
    the folder they need
    - checked: every script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
2026-10-05 The web page's video stream is gone from the cores (WEBVID, off); the network keeps the register API
    The picture goes to HDMI. eth_top's WEBVID (default 0) removes what only the web
    page used:
    - net_core's frame streamer: never started, so synthesis drops it and its
    packet buffer
    - the NES / Master System / Mega Drive framebuffer in regfile (video.v: 24
    block RAMs and 5k LUTs); the PlayStation keeps its slow read of the DDR3
    frame (a few dozen LUTs), the one way left to see a picture over the network
    - the console's stream registers (ctrl 0xF0 reads 0), and with them the
    DDR3-copy reader and the PlayStation's scanout stream
    pc/server.py copes: no stream -> the PlayStation's frame re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
2026-10-05 N64: the AI's clock fixed (it played 77% of its samples), the memory port unblocked, the RSP's write DMA pipelined
    Measured on the board (tools/n64/n64perf.py), SM64 drew 20.6 frames a second, the
    RSP 86% busy -- 36% of its time in its DMA wait -- and the AI played 24,632 of
    the 32,006 samples a second the game set.
    - The AI: its video-clock accumulator summed in 26 bits and wrapped past 2^26: a
    quarter of the ticks were lost, the DAC ran at 37.5 MHz, exactly 24,636
    samples a second, SM64's buffers piled up and it dropped them. (Not the game's
    speed, as CHANGELOG said.)
    - The HDMI picture's lines are read pipelined, tagged as a fourth owner of the
    pipelined port: one round trip each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
2026-10-05 N64: a fast path for single-precision add, sub and multiply; the RSP's DMA reads ahead of the CPU's
    The board's timeline (tools/n64/n64timeline.py) shows SM64's frame: the CPU busy
    about 35 ms on the next frame while the RSP spends 25 ms on graphics and 4.5 ms
    on audio every vblank -- both just past the 33.3 ms a frame at 30 needs. The
    CPU lost 22% of its clocks to the FPU (an add took eight clocks, a multiply nine
    or more, the CPU waiting through them).
    - vr4300_fpu.v: ADD/SUB/MUL.S of two normal singles, rounding to nearest, no
    exception enabled, go through a pipeline of their own: four clocks for an add,
    three for a multiply. A result that is not a normal number goes back to the
    ge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
2026-10-05 N64: the FPU's fast path taken with Invalid enabled (as SM64 runs); the RSP first only while its DMA waits
    - vr4300_fpu.v: the fast path asked for no exception enabled, and libultra sets
    FCR31 with Invalid enabled, so SM64 never took it (FPU busy still 17% of the
    CPU's clocks on the title screen's face). Only Inexact's enable matters for two
    normal operands. tb_vr4300_fpu: 40,000 fast-path operations with enables as
    games set them, 100,000 general and the usual 40,000 agree with the model.
    - n64_top.v: the RSP's read-ahead goes before the CPU only while the RSP's DMA is
    waiting for a line; always first, its prefetch window kept the CPU's I-cache
    misses waiting 87 clocks.
    - tools/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
2026-10-05 N64 CPU: a load's data forwarded from W to the ALU; the forwarding compares a clock ahead
    - A load in W goes on to E's ALU (32-bit ALU ops without exceptions: ADDU, SUBU,
    logic, shifts, SLT(U), ADDIU, SLTI(U), ANDI, ORI, XORI) and to a store's data
    (SB/SH/SW/SD), through a second set of operands (fa, fb) and result (res_f)
    that reach neither the address, nor a branch, nor anything that raises an
    exception -- the path that kept a load's data from being forwarded at all.
    tools/n64/n64loaduse.py: SM64 uses a load one instruction after it, and a third
    of those uses are these; load-use stalls 204 -> 112 clocks per 1000
    instructions in the model's count.
    - The register-number compare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
2026-10-05 N64: a D-cache next-line prefetch; an FP load holds back only what it concerns
    Board (the previous commit's image): SM64's title-screen face 20.6 -> 24 frames a
    second, play 30; load-use stalls 14% -> 7.9% of the CPU's clocks.
    - n64_top.v: a D-cache miss's fill asks for the next line right behind it (owner
    tag 4: the tags are three bits now), and the line goes into the cache when it
    comes back -- on a clock the data and tag write ports are both free, together --
    unless anything wrote it meanwhile (a CPU store, any write the memory took, the
    sweep, a CACHE op). A prefetch whose request was not yet taken when the fill's
    own line returned is dropped there and then.
    - vr4300.v: an FP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
2026-10-05 N64 CPU: an FPU operation that cannot trap no longer holds E
    Board (the previous commit's image): SM64's title-screen face ~25 frames a second,
    play 30. The face's CPU stalls: FPU busy 15.2%, D-cache 12.8%, load-use 7.2%,
    FP register 5.6%, fetch 5.0%.
    The FPU says at start whether the operation can trap (asy: the fast path's
    ADD/SUB/MUL.S, with FS set and Overflow and Underflow not enabled -- SM64's
    FCR31). Such an instruction goes on the clock after it starts, and its register
    and FCR31's cause and flags are written when the unit is done (fp_pend), on a
    clock W's FP load does not have the write port. Until then the COP1
    instructions wait (and do not start the unit: a start took over a pend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
2026-10-05 The console runs on the board's oscillator; the LAN module is optional
    Every image ran on the LAN8720 module's 50 MHz REF_CLK, so without the module
    nothing ran. Now the console (eth_top) and the shell run on an MMCM output from
    the board's oscillator (cclk, 1000 MHz / CLK_DIV, 50 MHz unless a build says
    otherwise), and net_core alone stays on REF_CLK, reaching the register bus through
    net_bridge.v: the request latched and a toggle across, the answer latched and a
    toggle back. Without the module that side sits in reset and the ESP32 is the only
    master. The crossings between the console's clock and the memory controller's
    and the picture's, all now from one oscillator, are declared unrelated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
2026-10-05 The shell draws the menu; the PC's pad drives every console
    The board starts in the shell, and with no console in the slot (or one that will
    not boot) it showed "ready" and nothing could be done from the sofa. Now the shell
    carries what the menu needs: esp_bus beside its own ESP32 door on the same four
    wires (the bus commands are its, the flash commands the shell's), osd.v's page --
    the cells shell_screen already drew its progress in -- and a pad page (pad 1 and 2,
    the console 0, so the NES's order) on one register bus with the LAN's, through
    bus_arb. Its version is 2. The ESP32's menu (menu.h) draws there when the shell is
    version 2 and no longer boots the slot at power-up: picking a game i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
2026-10-05 The pad over the ESP32's USB port; the shell guards its flash; the picture fits
    No more network in the pad's path: pc/pad.py sends the pad's state down the ESP32's
    USB serial port ("P buttons lx ly rx ry", on change and ten times a second), and
    pads.h lays it out for the console running -- or for the shell's menu -- and writes
    it to the board, as it does a Bluetooth pad's (one translation for both now). A PC
    quiet for a second has let go. (Through the server and the LAN a lost packet held
    the board "gone" for most of a second: presses landed late, and a release that did
    not land turned a press into the menu's auto-repeat.)
    A NES slot was found blank after the ESP32 was reset under the runni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
2026-10-05 No network in the images: the ESP32 is the board's one way in
    eth_top and shell_top take NET (0 as built): without it there is no net_core, no
    net_bridge, no PHY reset, nothing on the LAN module's REF_CLK. The RMII and MDIO pins
    stay in the constraints, driven low (MDIO left floating); led1 says the console is
    out of reset (the shell: the flash busy). The bus arbiter's first master asks
    nothing. NET = 1 builds the network back exactly as it was.
    Checked: tb_shell, every check (the bench still drives REF_CLK; nothing uses it).
2026-10-06 N64 sound: an RSP LRV filled its register from byte 0; the HDMI picture and sound
    The sound was garbage because every LRV -- the audio microcode's load of its
    sample buffers -- put its bytes two (or so) places off in the register. The fast
    path set f_start to 16 - (a - e) and, in the same clock, a later assignment for
    every fast vector load set it again to the LQV's in-quadword offset: 0 for an LRV.
    Graphics barely use LRV, krom's RSP tests do not reach it, and the picture was right.
    Found by replaying SM64's audio tasks in the model and in tb_n64_rsp and holding the
    vector registers' changes and the stores side by side (tools/n64/rspstores.py): the
    first difference was v19 written two bytes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
2026-10-06 Tools without a network: the board's registers through the ESP32; the sound's checks
    pc/pad.py holds the ESP32's USB port and passes the PC's tools through on
    127.0.0.1:5557: "R addr", "W addr value", "D addr n" (a block, at the link's speed)
    and "P ..." (a button press in place of the pad's for 0.3 s); the ESP32 answers the
    first three (console.ino). tools/n64/n64dbg.py reg() goes that way, so every N64
    measuring tool works with no LAN. tools/toolpad.py presses buttons.
    tools/n64/aring.py: what goes to HDMI as sound -- the audio ring read in one piece,
    as a WAV and a picture. tools/n64/modelaudio.py: a game's sound as the model plays
    it, to hold against it. tools/n64/rspstores.py: a captur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
2026-10-06 The picture's settings: the N64's real VI filters, dedither, scaling, scanlines
    n64_vid (the N64's and the PlayStation's HDMI path) keeps a four-line ring and a
    window round each pixel, and does what the real VI does to the frame -- anti-
    aliasing of partly covered edge pixels, the restore (dedither) filter, divot,
    gamma, as MAME's notes (rdpfiltr.ipp) and Nintendo's patents describe them --
    then scales it: as the console, sharp, smooth, or edge-directed, with scanlines
    if asked. The window runs a row ahead and a line store keeps the filtered rows,
    so every neighbour the scaling uses is filtered too.
    What the game sets in VI_STATUS is the default; register 0x17C (opt) overrides
    each part, a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
2026-10-06 Room for the picture's filters: no logic analyser in the N64 image, the AA's sort at 5 bits, no dedither for the PlayStation
    The N64 image would not place (slices) and the PlayStation's missed timing at
    99.8% of its slices. The analyser has had no reader since the network went; the
    anti-aliasing's second-largest / second-smallest are found on the 5-bit colour
    (exact for a 16-bit frame, whose 8-bit values are the 5-bit ones widened); the
    PlayStation's GPU never dithers here, so its copy of the filter has no restore.
2026-10-06 N64_DBG: a shipping N64 image without the debug window
    core.sh n64 takes N64_DBG=0 (default 1): the window then shows only the VI
    interrupt count, the instructions retired and the AI's state; the counters, the
    timeline's RAM and the RSP's and RDP's logs behind the rest have no reader left
    and synthesis drops them (about 1,200 LUTs).
2026-10-06 RSP: the multiplies' accumulator inputs and clamp decoded when the op is latched, a copy a lane
    q_fn's decode and its fanout to all eight lanes were most of the clock on the
    path through the accumulator adder into vw_data -- the RSP's longest at 62.5 MHz
    (16.9 ns). The selects are now registers beside q_fn, one per lane; the logic is
    the same opcode for opcode. krom's RSP tests: 56 OK; four SM64 tasks
    (tools/n64/rspstores.py) store what the model stores.
2026-10-06 tools/sdcore.sh: built console images onto the ESP32's SD card over Wi-Fi
    The running game is left alone; the menu installs the card's image when a game for
    that console is picked and the slot holds another.
2026-10-06 Frame tools: the board's N64 frame (fbgrab) and the model's with its hidden bits (fbmodel), through the VI filters
    fbgrab stops the N64 (its frame stays in DDR3), reads the VI's buffer through the
    tool port and runs n64_vid's model on it in each mode; fbmodel plays a ROM in the
    model and runs the VI filters with the true coverage and with the board's guess.
    They showed the guess costs little, and that the RDP's own coverage (memory read
    as hidden = 11) is what puts specks on SM64's edges.
2026-10-06 N64 toward 62.5 MHz: the CPU's, FPU's and RDP's long paths cut
    CPU: exceptions found late in M (replayed), COP0 writes a clock late, the TLB in
    LUT RAM banks with an 8-clock search, W-forwarding only for loads. FPU: normalise
    and the multiply's exponent split. RDP: texture mask/mirror a stage later, the LOD
    maximum as a tree. n64_top: the memory arbiter no longer waits on the CPU's request
    lines (a miss waiting is served whatever the CPU asks that clock).
    krom's CPU tests: 103 OK (all but the two that count cycles); the RDP's so far
    only fail where the committed RDP does too (copy mode, YUV). tools/ooc.tcl -impl,
    rspstores' RDRAM 16 MB.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
2026-10-06 hdmi_tx: RES 1 for 1280 x 720 (74.25 MHz, VIC 4, its ACR); tb_hdmi_tx720
    The island positions follow H_ACT / H_TOT, the counters and x/y are 11 bits. Not
    used by any image yet (the link's 371 MHz serialiser is untested on the board);
    tb_hdmi_tx (480p) and tb_hdmi_tx720 both pass.
2026-10-06 Interrupt tests for the N64's CPU; tb_n64_top +NOTRACE +STOPEXC
    tools/n64/n64irqtest.py: stores and the loads that read them back (SM64's prologue
    among them) while interrupts arrive at random -- the bench's IP2 (tb_vr4300 IRQ1)
    and the CPU's own timer -- the program counting its mismatches. On the CPU alone
    and on the whole N64 (--system): 0 mismatches. krom's tests never take one.
    tb_n64_top: +NOTRACE (a long game run would write gigabytes of trace) and
    +STOPEXC (the last 512 instructions at the first exception that is not an
    interrupt, and stop): for finding where SM64 faults with db13850.
2026-10-06 n64irqtest: FPU work under interrupts too (exact single-precision answers, the count through a float)
2026-10-06 CPU: the TLB's match was built a bit short -- every lookup through it missed
    tsr is {hit, v, d, c, 0, pfn}, 27 bits; it was built 26 wide, so the hit fell off the
    top ([26] always 0) and v, d and C were each read a bit off. Every access through the
    TLB took a refill. SM64's goddard maps its heap at 0x04000000 (two global entries of
    64 kB pages) and hung on its first load there, about 5 s in, with db13850 on the board.
    krom's tests never translate an access through a valid entry; found with a retire ring
    on the board (the last 512 instructions at the fault) held against the model's.
    tools/n64/n64tlb64k.py: SM64's mapping as a CPU test (osMapTLB's sequence, both halves of
    both entries, goddar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
2026-10-06 N64: a retire ring for the board (DBG builds), and the arbiter's CPU-request guards back
    n64_top keeps the CPU's last 512 retired instructions, frozen at the first TLB,
    address or bus fault; dbg_sel[28] reads them (tools/n64/rtring.py). With it the
    SM64 hang was found in a minute: the fault, and the instructions before it, held
    against the model's around the same PC (tools/n64/modeltrace.py).
    The !c_dreq / !i_req guards db13850 took out of the memory arbiter are back while
    the 62.5 MHz work goes on: the hang was not theirs (the TLB), but with them the
    pending-store completion cannot meet a new request in the same clock, and 55.6 MHz
    closes with them.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
2026-10-06 PS1: its timing worked out from CLK_HZ, so it can run faster than 50 MHz; core.sh PS1_DIV
    The console-rate enable (33.8688 MHz), the GPU's 60 Hz raster and swap waits, the
    drive's command, seek and sector times, the pad port's byte time and the raster's
    console-pace mode were all counted in 50 MHz clocks. They now come from CLK_HZ
    (every value the same at 50 MHz), so a faster core clock speeds up only the CPU and
    the drawing engine -- what Crash's heavy frames, 1.4% over two vblanks, are short of.
    tools/ps1/ps1fps.py: the frame rate from the display flips, over the tool port.
2026-10-06 SNES: the 65C816 as a model (tools/snes/w65816.py), checked against SingleStepTests
    Every opcode in native and emulation mode, the addressing modes with the 6502's page
    wraps where the chip keeps them (emulation, DL = 0), decimal ADC/SBC at both widths,
    the stack's page-1 rule for the old instructions and not the new ones. Bus access by
    callback, in the chip's order. tools/snes/sstest.py runs the SingleStepTests 65816
    suite (sim/roms/snes/ss65816): every file present passes on registers and memory,
    but MVN/MVP, which the suite samples mid-instruction after 100 cycles.
    The SNES is next after the N64 and the PlayStation run at full speed; this is the
    groundwork done while their builds run.
    C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
2026-10-06 SNES: the SPC700 as a model; both CPUs match their SingleStepTests suites cycle for cycle
    tools/snes/spc700.py: the sound CPU -- the P-selected direct page, the bit-addressed
    ops, the 16-bit word ops, MUL / DIV (the chip's overflow rule), DAA / DAS, TCALL /
    PCALL. tools/snes/spctest.py: all 256 opcodes pass 10,000 tests each on registers,
    memory and the number of cycles.
    65816: 510 of 512 opcode/mode files pass on the same terms (MVN / MVP are sampled by
    the suite mid-instruction). Found on the way: in emulation mode (dp,X) wraps its
    index in the page but not the pointer's second byte; JSR (a,X) keeps its stack in
    page 1; WAI and STP take three internal cycles.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
2026-10-06 SNES: the PPU and the whole system as a model, checked on krom's screenshots
    tools/snes/ppu.py: VRAM / CGRAM / OAM and their ports, BG modes 0-7 (16x16 tiles,
    offset-per-tile, mode 7 with EXTBG and its screen-over modes), sprites (sizes,
    range / time over, priority rotation, OBJ interlace), windows, colour math, mosaic,
    brightness, hi-res (modes 5 / 6), pseudo hi-res and interlace, drawn a line at a
    time. tools/snes/snes.py: the bus with the 6 / 8 / 12-clock regions, DMA, HDMA
    (direct and indirect), NMI, H / V IRQ, multiply / divide, the WRAM port, LoROM and
    HiROM, and the APU ports. tools/snes/kromtest.py runs every krom test that ships a
    screenshot and counts the pixels that differ.
    Every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
2026-10-06 SNES model: mosaic in hi-res / interlace, a held pad; every still krom PPU picture matches
    The mosaic counts lines before the interlace field doubles them, and stays in
    512ths across in hi-res. snes.py --joy holds pad 1's buttons (218/219);
    kromtest holds R for the two mosaic demos to the screenshot's size (16). A
    screenshot 225 rows tall kept line 0 and is compared one row down
    (HiColor1241DLair: exact).
2026-10-06 SNES: the S-DSP model, SPC timers and $F0-$FF; the 65816 model checked bus cycle by bus cycle
    tools/snes/dsp.py: eight BRR voices with the Gauss interpolation (the table
    Fullsnes lists, with its overflow rules), ADSR / GAIN on the shared rate counter,
    pitch modulation, noise, KON / KOFF taken every other sample, the echo ring and
    its 8-tap FIR, the mixer. apu.py: $F1 (timers, port resets, the boot ROM),
    $F2 / $F3 to the DSP, the three timers at 8 / 64 kHz, all kept in step with the
    SPC700's cycles. blargg's spc_timer passes.
    The boot ROM's block header is now shorter (MOVW), so its jump leaves A = X = Y =
    0 as games expect; gilyon's spctest still passes through it.
    sstest.py --bus compares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
2026-10-06 PS1: CD / pad timings no longer overflow a Verilog integer; the SPU's all-pass negation out of the path
    120000 * (CLK_HZ / 1000) is past 2^31, so the CD drive's second-response delay came
    out at 34100 cycles at 50 MHz and 40415 at 52.6 instead of 120000 / 126315: the
    52.6 MHz image loaded Crash 2's EXE corrupt (reserved instruction at its entry,
    80010000h). The counts are now (CLK_HZ / 1000) times small factors -- exact at
    50 MHz. (The image on the board was built before the scaling went in.)
    ps1_spu: the negated all-pass coefficients are registered a clock ahead, out of
    the reverb's multiply path (the 52.6 MHz build's worst path). tb_ps1_spu still
    bit-exact.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
2026-10-06 SNES: the 65816 in RTL, bus-cycle exact on 511,971 SingleStepTests cases; the SPC700 model bus-exact too
    rtl/wip/w65816.v: the CPU cycle by cycle -- outputs a function of the state, so the
    system can time each cycle by its address; every addressing mode with the D-low and
    index penalties, decimal ADC / SBC at both widths, the emulation-mode stack and wrap
    rules, MVN / MVP a byte per pass, interrupts in place of an opcode fetch, WAI / STP.
    sim/tb_w65816.v checks every bus cycle (address, data, read / write / internal) and
    the registers and memory after, for 1000 cases of every opcode in both modes: all
    512 files pass, MVN / MVP mid-block included. tools/snes/sst2vec.py makes the
    vectors and l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
2026-10-06 PS1: ps1load.py -- flips and what bounds them, second by second, over the ESP32 tool port
    Display flips plus the drawing engine's and the stalled CPU's share of the clock,
    from ps1_top's perf counters through console 0xEC (the index only: the mode bits
    stay at their defaults). Crash 2's attract demo on the 52.6 MHz image: 29-31
    flips a second, the engine at most 89% busy, the CPU held 20-29% -- nothing
    saturated; the zero stretches are level loads (engine at 0%).
2026-10-06 SNES: the 5A22 in RTL (CPU timing, $42xx / $43xx, NMI / IRQ, DMA, HDMA); gilyon's cputest passes on it
    rtl/wip/snes_cpu.v: the 65816 core inside the CPU chip -- every cycle a slot of
    6 / 8 / 12 master clocks by its address (FastROM by MEMSEL), the CPU's $21xx
    accesses on the B bus, one bus port with an acknowledge so a slow cartridge read
    stretches its slot; the registers at $4200-$421F (NMI / H / V IRQ, multiply,
    divide, the pad auto-read, HVBJOY) and the eight DMA channels; GP-DMA (8 clocks to
    start, 8 a channel, 8 a byte, the read and the write in one slot) and HDMA (its
    frame-start setup and its run at H = 1104, direct and indirect), all to the
    model's rules. rtl/wip/snes_timing.v: the H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
2026-10-06 SNES: the S-DSP in RTL, sample for sample with the model on 8 krom sound ROMs
    rtl/wip/snes_dsp.v: the sound chip worked out one sample at a time in the model's
    order -- KON / KOFF every other sample, the KON delay and its three early decodes,
    BRR with the four filters, the Gauss interpolation (its table a generated ROM,
    rtl/wip/snes_gauss.vh) with its 16-bit wrap and clamp, ADSR / GAIN on the shared rate
    counter (periods 1 / 3 / 5 << n, no divider), pitch modulation, noise, the mix, the
    echo ring and its FIR, mute and echo-write-disable. ~1200 clocks a sample of the
    ~1560 there are at 50 MHz.
    tools/snes/dsprec.py records the model's DSP register writes, the SPC700's RAM
    writes and every sam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
2026-10-06 N64 RDP: two more pipeline stages in the pixel path (K before the depth compare, L before the LOD select) for 62.5 MHz
    n64_rdp_pix.v: K registers the depth compare's inputs (the masked Z, the delta-Z
    product and its 8-bit form, coplanarity, max Z, the blend shifts, overflow, the
    memory word and its coverage); S compares from them. L registers the four LOD deltas'
    maximum and the perspective overflow, and E does the thresholds and the tile
    select. pipe_occ counts both. krom's whole RDP suite through the split RDP: 105 OK;
    the 22 failures are the known ones (copy mode, YUV, TLUT / internal palette, alpha
    compare, two-tile, texture coordinates), which fail on the unsplit RDP too.
    tb_n64_top ST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
2026-10-06 SNES: the whole machine in RTL, wired in as a console (CORE_SNES, core.sh snes, the ESP32 menu)
    rtl/snes_top.v: the 5A22, PPU and sound unit with 128 kB of work RAM and its $2180
    port, the cartridge through cart_cache (LoROM / HiROM, mirroring by a size mask,
    32 kB of save RAM in its two places), the master and sound clocks from CLK_HZ by
    phase accumulators, each line drawn as it starts and the last one handed on 256
    wide. rtl/snes_apu.v: the SPC700 with our boot ROM, 64 kB of sound RAM shared with
    the DSP, $F0-$FF and the timers. The verified modules move out of rtl/wip.
    sim/tb_snes_top.v + tools/snes/rtlframe.py run a ROM on the whole RTL machine and
    compare its picture with the model's: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
2026-10-06 SNES: the PPU's VRAM and layer lines as block RAM; the image fits (27.5k LUTs, 117 block RAMs)
    The first SNES build asked for 34,000 LUT-RAM cells and 53,000 LUTs of logic: VRAM,
    read from two always blocks, had gone to distributed RAM, and the four 512-entry
    layer lines (a 2-D array read twice a clock) to 24,576 flip-flops and their
    multiplexers. VRAM is now a true dual-port block RAM -- port A the CPU's writes with
    byte enables and its prefetch reads (landing two clocks later; the CPU's accesses
    are 14 or more apart), port B the renderer -- and each layer line a snes_lbuf, its
    port A written by the fetcher a clock after it decides or read for the main column,
    port B for the sub column; the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
2026-10-06 SNES timing: the DSP's rate test, Gauss taps and echo FIR spread over clocks; the 5A22's divider a bit a clock
    The first routed SNES image missed 50 MHz by 13.9 ns, every one of the 60 worst paths
    in the DSP (the 32-rate counter test, four Gauss multiply-adds and the 8-tap FIR, each
    in one clock) or the 5A22's divider (a 16-by-8 divide in one clock). Now: the rates
    that step this sample are worked out once into a 32-bit vector (two stages a rate,
    ~66 clocks); each Gauss tap fetches, then multiplies and adds; the envelope multiply
    is its own step; the FIR takes a tap a clock. The DSP still has ~1300 of its 1560
    clocks a sample; Twinkle, PitchMod and PlayNoise match the model on all 79,769
    sam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
2026-10-06 tb_snes_dsp: measure each sample's whole time and fail past 1500 clocks
    The bench compared samples but never timed them, so nothing showed the DSP's work fits
    the 1562 clocks a 32 kHz sample has at 50 MHz. It now runs each sample until the work
    is done and gates the longest: 207 clocks on Twinkle, 169 on PlayNoise. (The last
    commit's estimate of ~1300 was a guess and wrong.)
2026-10-06 SNES PPU timing: mode 7 and the mosaic without dividers, the compositor in four stages
    The routed image missed 50 MHz by 4.5 ns, all of it in the PPU: mode 7's column (a
    mosaic modulo, two 16x9 multiplies, the sums and the range test in one clock), the
    compositor's pixel (the pick, CGRAM, colour maths and brightness in one), and the
    layers' mosaic columns (a 9-bit modulo by a register). The mosaic remainders are now
    kept as the column steps (1, or 2 in hi-res), mode 7 multiplies in its own state a
    clock before the sums, and the compositor picks, then reads colours, then blends.
    All 48 krom PPU replays (Mosaic and Mode7 among them) still match line for line.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
2026-10-06 SNES DSP: the BRR decode in two clocks a sample (the buffer reads, then the filter)
    The last routed image missed 50 MHz by 1.2 ns, every failing path (1432) from a
    voice's buffer position through the 96-entry sample buffer's two reads, the BRR
    filter and the clamp into the buffer's write. The reads and the shifted nibble are
    now registered a clock before the filter. Twinkle and PlayNoise match on all 79,769
    samples; the longest sample is 223 clocks of 1562.
2026-10-06 Menu over the SNES: cross picks, circle goes back (as over every other console); menunav after a load
    The SNES's pad layout is by position (cross is its B, circle its A), and the menu took
    the SNES's A as its own pick -- so circle picked and cross went back, the other way from
    the NES, N64 and PlayStation. menunav read a stale 'open' line straight after a load and
    skipped opening the menu; a 'menu: loaded' line now means closed.
    On the board (50 MHz SNES image, slack +0.279 ns): gilyon's cputest-full ends at its
    success loop (00:81A2) and spctest at its (00:8060), the same places the model's runs end
    with 'Success'; krom's HiROM FastROM bank test reaches its last JMP.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
2026-10-06 Guide: the Super NES (SD folders, its state as tested, its button layout)
2026-10-06 ESP32 T8: its microSD slot's real pins (13 CS, 15 MOSI, 14 CLK, 2 MISO)
    The classic-ESP32 build had the T8 slot on 27/12/14/33, from the LilyGO repo's old example;
    the V1.7.1 schematic has IO13 CS/D3, IO15 CMD, IO14 CLK, IO2 D0. (IO12, which the old pins
    drove, is the flash-voltage strap.) The T8 image compiles: 1.34 MB of 3 MB.
2026-10-06 ESP32 T8 brought up: no pin scan over its flash and PSRAM; link diagnostics
    The classic-ESP32 build reset and pulled the S3's 'safe' pins at power-up, 6-11 and 16/17
    among them -- the T8's flash and PSRAM -- and hung until the watchdog restarted it, before
    setup() printed a word. The T8 gets its own list. Also: the FPGA link's power-up pin check
    is printed when the FPGA does not answer, and the serial console has 'pins', 'linkprobe'
    (the link's wires with the FPGA running, held in configuration, and loaded again: pulls
    only) and 'linkraw' (a status frame's raw bytes at 0.25-8 MHz, modes 0 and 1).
    On the board: the T8 reads the card in its own slot, the shell answers A5 02 00 at every
    clock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
2026-10-06 The new menu: BYBA GAMES start-up logo, settings for the picture, Wi-Fi, controllers and system
    The ESP32's menu is rebuilt on osd.v version 2 (its own glyphs and palette):
    - ui.h: the screen kept on the ESP32 and sent as it changes; text, frames, panels, big
    letters (quadrant glyphs), the logo, QR codes; plain characters on a version-1 board.
    - screens.h: every page drawn from plain data, so tools/menu_preview renders them on the PC.
    - art.h (tools/menu_art.py): the logo (a mascot cut into two-colour 8x8 tiles, checked),
    icons (the pad's buttons in their colours, Wi-Fi bars, Bluetooth, a pad, a padlock...),
    a 5x7 title font. The start-up logo plays at power-up while the card is read.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
2026-10-06 Menu: how to connect a controller, on the consoles page while none is
    Out of the box there is no pad and nothing to press: Bluetooth takes new pads from power-up,
    but nothing said so. With no controller connected the consoles page says how (PS4/PS5
    SHARE + PS, Xbox pairing button, Switch Pro sync); it goes as soon as one connects.
2026-10-06 Menu: a closed menu draws nothing (it came back over a game that had just started, deaf)
    After a game loaded, the same pass of the menu's loop fell through to the consoles page's
    once-a-second redraw, which put the menu back on the screen -- closed, so it answered only
    START + SELECT. draw() now does nothing while the menu is closed (on the board: the overlay
    off after the load and staying off). On an image built before osd.v version 2, About and the
    phone page say it in words instead of drawing a logo and QR codes out of '#'.
2026-10-06 Menu log after the press, with the highlighted item; menunav steers by name
    The menu's 'buttons' line was written before the press acted; it is now written once the
    press has done its work, with the item left highlighted. tools/menunav.py finds a console
    and a game by name (or index), so a 'Back to <game>' line at the top no longer throws it.
2026-10-07 SNES: a timer read in the clock the timer ticks sees the tick -- Super Mario World ran into a lost-tick hang
    The SPC700's timer output counters ($FD-$FF) clear when read. Our APU returned the old count
    and cleared it when a read fell in the very clock the counter stepped, so that tick was lost
    (the model counts it first, then the read returns and clears it). Super Mario World's sound
    driver waits on $FD in an 8-cycle loop (MOV Y,$00FD / BEQ); the timer steps every 128 SPC
    cycles, a multiple of 8, so once one read fell on a tick every read did, every tick was lost,
    and the driver never came back to answer the CPU's commands: the CPU waited at 00:8082 for the
    $BBAA upload handshake for ever (b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
2026-10-07 PS1: the MDEC -- the video decoder FMVs (and games that wait on it) need
    The PlayStation had no MDEC: DMA channels 0 and 1 finished the moment they started and
    1F801820h/24h read zero, so every FMV was black and Resident Evil 2 froze on its intro.
    - docs/MDEC_NOTES.md: the chip, from psx-spx and behaviour descriptions of three emulators
    (no code copied); Mednafen's arithmetic recommended (no bit-exact IDCT is published).
    - tools/ps1/mdec.py: the model -- dequantisation to a 15-bit IDCT input, two passes (vertical
    first, (sum + 4000h) >> 15, the scale table cut to 13 bits), a 9-bit wrap and clamp, YCbCr ->
    RGB (359 / -88 / -183 / 454), 15/24-bit colour and 8/4-bit mono output, signed an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
2026-10-07 ESP32 T8: the menu's memory -- game names in PSRAM, its task before the card scan; uploads make folders
    On the T8 Bluetooth leaves ~25 kB of internal RAM. The card's game list (hundreds of small
    Strings) broke it into pieces: the largest was 4 kB, Wi-Fi's buffers ran out (the web server
    stopped answering mid-upload) and the menu task's stack would not fit. Game paths and names
    now live in a pool in PSRAM (the lists too, with a PSRAM allocator), the save buffers there
    as well, and the menu task is created before the card is read (the logo plays while it is):
    internal RAM afterwards 24 kB free, largest piece 12 kB, lowest 16.5 kB (the state command
    prints these). An upload named with a folder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
2026-10-07 HDMI scaler: doubled down when 240 lines or less, whatever the width -- the PS1's wide modes filled the top half
    n64_vid doubled a picture both ways when it was 320 wide or less and showed it 1:1
    otherwise, so the PlayStation's 368-, 512- and 640-wide modes -- 240 lines -- came out undoubled
    in the top half of the screen (Gran Turismo 2's menus). Across and down are now decided on their
    own (hdbl: width <= 320, vdbl: height <= 240), a picture wider than 320 is centred, and the
    filters and scanlines (which want both) leave a mixed one sharp. tools/vidref.py has the same rule
    and three new cases (512x240, 368x240, 512x480); all 13 match the model pixel for pixel.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
2026-10-07 PS1 drive: a sector frame that began before the ring restarted is never taken -- Crash got its header as code
    Crash failed to boot one time in three to five, on every image back to yesterday's. Read out of
    RAM after a crash, the first 2048 bytes of its program at 80010000 were its PS-X EXE header
    sector (LBA 112018), and every sector after them was right. The BIOS reads the header, the
    drive reads ahead, and the ESP32 is part way through sending 112019 when Setloc(112019)+ReadN
    starts the ring again at slot 0: the frame's first bytes went into the old slot, its last few
    into slot 0 on top of the header, and its label and header -- both read at the start -- said
    112019, so it was taken. Such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
2026-10-07 ESP32 menu: the glyphs again only when the board lost them, and a console 'gone' only after three looks
    freshBoard() sent all ~500 glyph rows whenever the menu thought a console had come up -- and a
    single lost status frame on a busy link made a running game look new, so the glyphs went over
    the link in the middle of a PlayStation game's disc feed. Palette entry 7 tells: osd.v powers up
    with orange there and the menu sets black, so black means the glyphs are still in. And three
    status looks in a row must say the console is gone before the menu believes it.
2026-10-07 tb_ps1_cddma: the sectors read out of memory after a cache flush, not peeked out of the cache
    The bench looked a line up in the processor's write-back cache by its old 512-entry register
    arrays; since the cache moved to block RAM (4096 lines) that read nonsense and the bench failed
    with zeros, hiding whether channel 3 worked. It now pulses cc_flush and reads memory, as
    ps1exeverify.py does on the board: all three reads (LBA 16, 18, 24) are right.
2026-10-07 ESP32: XA audio decoded on the T8, for discs off the card -- Gran Turismo 2's music
    The drive queues every XA sector the game lets through and plays 44.1 kHz stereo from a FIFO;
    the PC decoded them when it served the disc, and off the card nobody did. xa.h is pc/cdaudio.py's
    XaDecoder (DuckStation's ADPCM and zigzag interpolator) in C++, checked word for word against it
    by tools/ps1/xatest.py: GT2 (37.8 kHz stereo), RE2 (37.8 kHz mono) and synthetic 18.9 kHz and
    8-bit sectors, filtered and not -- all identical.
    Where it runs mattered more than the decoder:
    - the card reader keeps 64 sectors BEHIND the drive (the queue's sectors have been delivered);
    - not a task (its stack out of internal R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
2026-10-07 PS1: the GTE debug snapshot and write trace; the MDEC back on the chip -- tables in RAM, dequantisation pipelined
    GTE snapshot (ps1_gte.v, console 0x190/0x194): armed to skip N commands, the GTE stops before
    the next one, the PC reads every register through the processor's own read port, 'go' runs it
    and it stops again after. Nothing is copied: a first version kept all 64 registers aside, 2,000
    LUTs and 2,000 flip-flops, and the console no longer fitted. tools/ps1/gtesnap.py replays each
    command in tools/ps1/gte.py: 30 of Gran Turismo 2's commands (MVMVA, NCLIP, RTPS, RTPT) match
    register for register -- the GTE is right; GT2's rotation matrix arrives with a zero middle row
    (every vertex on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
2026-10-07 PS1 scanout: 24-bit colour -- the way movies are shown; Gran Turismo 2's intro was colour noise
    GP1(08h) bit 4 was kept for GPUSTAT and nothing else (the header said the scanout halved
    24-bit colour; it did not): a 24-bit picture was read as 16-bit pixels. Read off the board
    during GT2's intro, the frame re-read as 24-bit is a dark scene, as 16-bit noise -- the noise
    the TV showed. Now pixel n is the three bytes at byte 3n of the row (red, green, blue), two
    VRAM columns a pixel, every other pixel starting in the column the last ended in, out as
    RGB555; a wide one at half width like the rest, never in line mode. tb_ps1_scan: four new
    captures (320 wide twice, an odd start at 100,16, 640 wide)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
2026-10-07 espshot.py: ask again when a block read comes back cut short on the serial link
2026-10-07 PS1 scanout: the crop keeps only rows inside the window on screen -- a movie shown at y=256 came out black
    A capture taken at a flip blanks the rows the game did not draw since the last one (rows under
    240 only, so textures below a y=0 buffer cannot widen it). A buffer shown at y=256 -- Gran
    Turismo 2's movies -- was cropped to whatever had been drawn up above it: rows that were never on
    screen, so every row it showed was blanked (16 lit pixels in a frame, on the board). The bounds
    are now clamped to the window shown; an empty overlap is no crop. Counting every row instead was
    tried and is wrong: the crop knows rows, not columns, and a buffer was cut to rows drawn in
    another buffer beside it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
2026-10-07 ESP32: an install whose task cannot start says so, instead of staying 'starting' and busy for ever
    /api/install and the serial 'install' made a task with an 8 kB stack from internal RAM and never
    looked at the result. With the menu, Bluetooth and the XA decoder in, the piece was not there: the
    job sat at 'starting', busy, and refused every install after it until a restart. Now a 503 / a
    message pointing at the menu, which installs inside its own task when the card's core differs
    from the slot's -- the way the PlayStation image went in today (11597 pages, verified).
2026-10-07 Interlaced and wide pictures at full resolution on HDMI -- Gran Turismo 2's and Smash Bros.' menu text
    PS1: a 480-line (interlaced) picture was captured one field -- every other row -- and anything
    wider than 320 at half width, which is what the old network stream could carry. GT2's menus are
    512 x 480i: a quarter of every glyph reached the TV. The scanout now captures both fields, 480
    rows (sc_last), at full width (no thinning, every column, 24-bit too); fb_ddr's two frames are
    0xA000 lines apart (640 x 480) and HDMI fetches up to 480 lines; fb_width/fb_height are the
    real size. The crop stays off for 480 lines (its bounds are rows under 240). tb_ps1_scan: every
    capture at full width, and a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
2026-10-07 PS1_DBG: a shipping PlayStation image without the debug hardware
    The performance counters (64 x 32 bits), the event ring, the GTE snapshot and write trace and
    the PC / register / GP0 / DMA-list traces are ~9,000 bits of flip-flops and their logic, on a
    chip at 99.9% of its slices. PS1_DBG=0 (core.sh) gates each one's write off; never written, it
    is a constant and synthesis removes it. Default 1: development builds keep all of it.
2026-10-07 PS1 SPU: the register file a byte lane an array -- 8,192 flip-flops become LUT RAM
    1F801C00h-1FFFh as written was one 32-bit array written a byte lane at a time from one process:
    synthesis built it in flip-flops with a 256-way read multiplexer, most of the SPU's 11,663
    flip-flops on a chip at 99.99% of its slices. Four byte-wide arrays, each written once a clock,
    and the CD volume (1DB0h, read by the mixer every sample) kept beside them. tb_ps1_spu (every
    sample against spu_ref.py) and tb_ps1_cdaudio pass.
2026-10-07 PS1 HDMI: 480i woven a field at a time, and a capture the scanout gives up never goes on screen
    480i: the GPU draws one field a frame, into the rows NOT on screen. Captured as 480 rows in one
    pass, the capture read those rows half drawn -- GT2's menu fine at the top and broken lower down,
    lines of the PS logo out of place (the user: 'as if the SCART cable was misplugged'). Now each
    field is captured while it is the one on screen (stable), its 240 rows into rows 2k + field,
    and fb_ddr writes it into the frame HDMI shows (weave), so the two fields make one picture.
    A progressive 480-line picture is still taken whole.
    Aborted captures: the scanout gives up a capture when the game flips under i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
2026-10-08 PS1: the console's own timing and behaviour, checked against ps1-tests on the board over JTAG
    Debugging over JTAG (debug image: core.sh PS1_DBG=1 JTAG=1): jtag_axi + rtl/jtag_bus.v on the
    register bus, tools/jtag.py; a TTY ring (BIOS putchar), a raw DDR3 window for VRAM/RAM dumps, a
    GPU input trace. tools/ps1/ps1suite.py runs JaCzekanski's ps1-tests on the board and compares
    with the console's own logs and VRAM dumps; exedisc.py builds the test discs.
    CPU: paced by what each instruction costs the console (load times per region from cpu/access-time,
    instruction-cache model, MULT/DIV/GTE latencies), at the console's pace by default; coprocessor-
    unusable exceptions; instruction bus errors; BI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
2026-10-08 PS1: the console's pace for the GPU and DMA, measured against ps1-tests on the board
    GPU
    - Drawing paced to the console's own time (DuckStation's model, which the console's
    gpu/bandwidth log bears out): two ticks a system clock, a pixel one tick flat, two
    textured, x1.5 blended or mask-checked, plus each command's setup. Flat rectangles
    and quads drew 1.55x too fast; now 464/467 ms against the console's 481/489.
    - Semi-transparent drawing 3.26 -> 1.90 clk/px: destination lines come as runs, held
    per line in the cache (a write no longer throws the whole run away, and one landing
    mid-flight is no longer forgotten), and the block writer holds a destination read
    only for its own bloc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
2026-10-08 PS1: every GPU picture test of ps1-tests passes on the board but one; MDEC, DMA and 480i fixes
    Checked on the board with the debug image t19: gpu clipping, clut-cache, gp0-e1, mask-bit,
    quad, rectangles, texture-flip, texture-overflow, transparency, triangle, uv-interpolation,
    vram-to-vram-overlap, cpu cop, dma dpcr/otc-test, gte test-all, spu memory-transfer pass.
    gpu/lines differs by 64 pixels -- the test's own uninitialised RGB3, taken from the stack.
    - Gouraud and texture interpolation as the console does it: gradients of twelve fraction
    bits truncated toward zero, taken from the leftmost vertex (Mednafen/DuckStation).
    - Polygon setup pipelined: 1/area two bits a clock, then a gra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
2026-10-09 PS1: an interrupt on a GTE command runs the command; GTE vertices overlapped; disc EDC checked
    GT2 hung on the board (GPU wedged in a CPU->VRAM transfer, BIOS waiting at bfc04218) because a
    polygon's packet went out with the PREVIOUS polygon's command word. GT2 writes command words
    straight from the GTE (DPCS, then SWC2 RGB2). An interrupt landing on the DPCS was taken before
    it; on the R3000 the command has already gone to the GTE, and the BIOS handler returns PAST a GTE
    command at EPC -- so ours never ran it. r3000 now issues a GTE command at PC with the interrupt
    (irq_take / irq_x). tb_r3000_gt2 (BIOS-style handler) reproduces it: old CPU 8/42 wrong command
    words, fixed 0; GT2 ran 57 min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
2026-10-09 PS1: the long CPU lead and DMA charge on by default; a zero EDC means none recorded
    ps1-tests on the board with 0xEC = 0x19000 (lead 4,000, DMA a console cycle a word) give the same
    results as with both off -- every GPU picture test but gpu_lines, dma_dpcr, otc-test, gp0-e1,
    mask-bit, spu_memory-transfer, gte test-all 1150/1150 -- so they are the default now (console_top,
    ps1suite). GT2 runs 2-5 fps faster with them.
    The disc EDC check refused every sector of the test discs tools/ps1/exedisc.py made (it wrote no
    EDC): three tries each, and gte/test-all's 417-sector program missed the suite's window. An EDC
    of 0 is now "none recorded" for Form 1 as for Form 2 (a real sector's is 0 once in 2^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
2026-10-09 PS1: the write queue is pass-through, as on the chip -- GT2's frame cost was overcharged
    The CPU pace model made every load wait for every queued RAM store to drain. The chip's write
    queue (psx-spx "Write queue") is four words deep and pass-through: a load goes past it unless it
    reads a word still queued, or is a KSEG1 access, which flush it; a store costs nothing unless all
    four are still going out. GT2 builds packets by storing to the packet and loading from the model,
    and was charged a tenth of its time for waits a console never has. Same footage, same 300 s:
    23.9 -> 25.0 fps; DuckStation on this PC, same disc and BIOS, 27.4 in the race band against our
    25.9. chain-looping's loop reads th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
2026-10-09 PS1: a store keeps the write queue 8 cycles -- chain-looping matches the console again
    With the queue pass-through, chain-looping's volatile g += i (the load reading the word just
    stored) came out 15,024 ticks for the console's 16,040; 9 cycles gave 17,016, 8 gives 16,024 on
    the board. cpu/access-time's RAM reads 4.92/5.16/5.18 (console 5.21/5.30/5.14). GT2's race band
    25.8 fps (DuckStation, same disc and BIOS, 27.4).
    tb_r3000_cost (tools/ps1/costloops.py) runs the tests' own timing loops through the pace model in
    simulation and prints its console cycles -- a board result also contains real execution time, which
    the model can only add to, never take away from.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
2026-10-09 PS1: two CPU-pace experiments, off by default (0xEC bits 18, 19)
    Bit 18: a catch-up lead of 16,000 console cycles instead of 4,000. Bit 19: the processor may also
    run up to 4,000 cycles AHEAD in a stretch where it is faster, to spend where DDR3 or a DMA slows
    it. Same GT2 footage, race band: default 25.8 fps, 18 alone 26.2, 19 alone 25.9, both 26.4
    (DuckStation 27.4). The time the processor loses (12% of the console's, credit full) comes in
    stretches far longer than either lead: the display-list DMA waiting on memory for node headers
    (S_LLW 3.7% of all time) and packet words (S_RDW 1.6%), and cache misses. Kept for measuring.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
2026-10-09 PS1: a list node costs the processor the console's 8 cycles -- chain-looping passes
    ps1-tests dma/chain-looping: beside a self-referencing GPU list, a 16,040-cycle loop takes 25,632
    on the console -- the processor gets ~13 cycles between headers of ~8. Ours charged a header 1
    cycle (and only a node with words), and with the 4,000-cycle lead made the rest up: 15,016, full
    speed. Now every header (ll_hdr, empty nodes too) charges 8, and a list seen going round holds the
    bus HDR_HOLD clocks for the header before the processor's window: 27,016, text OK. GT2's race band
    unchanged (25.7 fps).
2026-10-09 ps1suite: skip timer-dump -- it needs a console with Timer0's clock pin rewired to RTS
2026-10-09 PS1: a CD seek takes as long as the distance makes it; fills ask for a line a clock
    - ps1_cdrom: the seek's length is DuckStation's model of the mech (GetTicksForSeek): forward within
    a track of the spiral, one track back, 50/100 ms under 7,200 sectors, the sled beyond (50 ms +
    0.85 s, log and linear in the distance), plus 0.5-1 ms jitter. It was 40 ms for any distance;
    ps1-tests cdrom/getloc expects the drive still seeking 90 ms into a 40-minute seek, and now is.
    - ps1_gpu: a fill asks for its next line in the clock the last is taken. FillScreen unchanged
    (164 ms, console 78): the VRAM write path, not the engine, is the limit.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
2026-10-10 PS1: the DMA reads around the processor's cache -- cpuToVram 1456 -> 998 ms
    ccache B_NOALLOC: a DMA read that misses fetches a run of four lines (first answered on its beat)
    and allocates nothing, so the processor's lines stay where they are. Allocating, a block transfer
    larger than the cache paid a DDR3 round trip, and often a dirty write-back, a line. The run is kept
    coherent by the cache already (a processor write or a dirty eviction clears its copy).
    ps1-tests gpu/bandwidth cpuToVram 1456 -> 998 ms (console 772); GPU picture tests, dma chain-looping,
    otc-test and gte test-all pass on the board.
    Also: tb_ps1_gpu checks a VRAM copy pixel for pixel and times a 320-wide one (RD sets the mem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
2026-10-10 tb_ps1_gpu: time a 320-wide opaque and semi-transparent rectangle (the semi one 4.4x the opaque, as on the board; 7.7 clocks a destination line at RD=6)
2026-10-10 Console interface, a sturdier ESP32 front door, and a GPU DMA that starts without the trigger
    - tools/console_ui.py: the console from this PC (http://localhost:8765): what the board runs and the
    card holds; put a core on the card and install it into the flash for good (the reboot register
    through pc/pad.py -- this board's PROGRAM_B wire does nothing -- then install, boot, check it came
    up); games from Downloads (unzipped) to /roms/<console>/. Files go a 2 MB piece at a time, each
    checked by CRC, a failed piece sent again, a stopped copy carried on.
    - ESP32: /api/put (a piece at an offset), /api/stat, /api/crc. Small allocations to PSRAM
    (heap_caps_malloc_extmem_enable): internal RA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
2026-10-10 PS1 WIP: the raster reads its next destination line ahead (ps1_vram_port second reader), and VRAM reads go straight to the cache (vram_wc's pass-through stage gone)
    Benches: tb_ps1_gpu semi 320x16 7533 -> 5743 clocks (RD=6), all PS1 benches as on main.
2026-10-10 console_ui: a copy carries on only from pieces checked to be this file's; the whole core checked once more; boot asked up to three times
    The card held yesterday's (shorter) ps1.bin: it was taken for a stopped copy of today's, only the
    last piece was sent, and a core made of two images went into the flash and the board stayed dark
    (back through the shell over JTAG). The first boot after an install does not always take (the
    menu asks twice); a good core was reported as not coming up.
2026-10-10 PS1: RAM mirrored over 8 MB (Syphon Filter keeps its stack at 807FFxxx), XA music that keeps up, and debug traps for the title-screen stall
    - ps1_top: RAM answers at every 2 MB mirror of the first 8 MB, for the CPU, its fetches and the
    DMA stall check (Syphon Filter crashed at boot without it).
    - ESP32: XA 18.9 kHz resampler in 32 bits (exact; 28 ms -> 9 ms a sector), XA in its own task,
    samples sent in one 10 MHz transfer; disc sectors at 10 MHz; SD at 20 MHz on the T8; the menu
    rescans the card after an upload.
    - Debug image only: SIO byte log (0xEC bits 29:24, perf 18/19); the GPU trace also freezes on a
    50 ms engine stall and on a processor store of a list header that points at i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
2026-10-10 PS1 DMA: a linked list steps aside between nodes for any other channel (Syphon Filter's title screen)
    Syphon Filter draws its title frame twice without clearing its layer tables, so a DR_AREA packet
    ends up pointing at itself (DuckStation shows the same list). libgpu's ClearOTag then starts
    channel 6 and waits for it -- here it never ran, because channel 2 never left the loop: the wait
    timed out after 4 s ("GPU timeout") and the game went to its demo instead of the menu.
    As on the chip (MiSTer dma.vhd: each node ends PAUSING -> OFF, channels arbitrated again), a list
    now parks at the next node when another channel wants the bus, and is picked up after it.
    tb_ps1_dmaloop (program from tools/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
2026-10-10 PS1 MDEC: a 256-word input FIFO and an IDCT twice as fast -- Syphon Filter's movies and title menu play
    Every Syphon Filter movie (989 / Eidetic logos, the intro, the title with its menu) stopped after a
    few frames: the player's "frame decoded" wait timed out (MOVIE.OVL error 39) because DMA1 waited
    for picture words the MDEC never produced. The frame's input buffer is rewritten with the next
    frame while the MDEC is still being fed; our MDEC took its input 32 words at a time, only when
    empty, and decoded a block in ~1100 clocks (DuckStation: 448 CPU clocks), so DMA0 was still
    reading the old frame's tail when the new one landed on it -- 27 macroblocks went missing.
    - Input FIFO 256 words, a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
2026-10-11 PS1 raster: rows end at the polygon's last pixel, a second-level palette store -- Syphon Filter's demo 16-18 -> 18.6-19.3 fps
    Measured on a replay of the game's own drawing lists (sim/tb_ps1_replay.v, lists captured from
    the reference emulator into build/, fed by tools/ps1/mkreplay.py): 667k -> 540k clocks a frame.
    - Row clipping: a row stops at the polygon's right edge and the scan stops below its last row,
    instead of running the whole bounding box (598k).
    - Palette L2: 8 slots of 256 entries in block RAM keep palettes the cache has loaded; a palette
    that comes back is copied in on chip instead of read from VRAM again. A VRAM write or fill over
    a slot drops it. Palette waits 116k ->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
2026-10-11 N64 RDP: COPY mode -- Mario Kart 64's menu and lap-time text was never drawn
    n64_rdp_raster ended every COPY-mode primitive at once, so every copy-mode TEXTURE_RECTANGLE
    (the way games draw 2D text and sprites) drew nothing. Now, as n64rdp.py copy_pixel /
    interpolate_st_copy / sample_texture_copy(_word) (parallel-RDP):
    - raster: copy primitives take the normal edge walk; s/t/w start at the span's value, moved
    (end_x - x0) >> dx_shift framebuffer words back when unflipped (sp_dx0); no depth lines fetched.
    - pixel pipeline: s/t/w step once per 64-bit framebuffer word; the pixel's offset in it goes to the
    sampler; the sampler's word passes the combiner, blender and depth test by (a 10-deep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
2026-10-11 N64: n64-systemtest boots (libdragon IPL3, RI, DMEM fetch race, COP0 no-ops), ISViewer, JTAG frame grab and a freeze
    - Boot: libdragon IPL3 ROMs boot the PIF way (0x40-0xFFF to DMEM, PIF registers, 0xA4000040);
    RI registers read as IPL3 leaves them (its warm-boot path, not RDRAM calibration).
    - CPU: a DMEM fetch given up behind a taken branch no longer hands its word to the branch target;
    unused COP0 functions are ignored, as the VR4300 does (was Reserved Instruction).
    - ISViewer (0x13FF0020 buffer, 0x13FF0014 count) to a 2 KB ring read back through the debug window;
    N64_ISV (default 0) builds it, chained eth_top -> regfile -> console_top -> n64_top; core.sh passes
    N64_ISV and JTAG_D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
2026-10-11 N64 RDP: the perspective divide's reciprocal -- two width bugs, 3D textures a step off
    n64_rdp_persp disagreed with n64rdp.py perspective_divide on 16,042 of 60,000 random (s, t, w):
    - rcp = ((ty * wnorm) >> 10) + tx was sized by its 17-bit destination, so ty * wnorm (up to
    1008 * 255) wrapped before the shift: the reciprocal was wrong for most w.
    - The table's first entry, 0x4000, was held in 14 bits and read 0: every power-of-two w divided
    by nothing (results 0).
    Now 0 of 60,000 differ (sim/tb_n64_rdp_persp.v, vectors from tools/n64/mkpersp.py).
    Found from a Mario Kart 64 race frame captured off the board (tools/n64/rdpcapture.py): the RTL
    reproduced the board exactly and differed fro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
2026-10-11 rdpcapture: grab retries until the list caught sets its colour image (Super Mario 64 sends a frame in pieces through one buffer)
2026-10-11 PS1 HDMI: the line fetch first and four reads in flight -- the band that crept up the screen
    In 480-line modes (the BIOS logo's 640 x 480) n64_vid's four-line ring leaves fb_ddr one HDMI
    line, 31.7 us, to fetch each 640-wide source line: 80 DDR3 reads. fb_ddr asked for them one at a
    time and only when the capture's writes had all gone, so while a capture was being written the
    lines came late and the ring showed one four rows old. The capture runs at the PlayStation's
    59.29 Hz and HDMI at 60, so the band of stale lines crept up the screen. 240-line modes have four
    times the slack, which is why only some modes showed it.
    Now HDMI's reads go before the capture's writes (the capture's queue is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
2026-10-11 N64: HDMI at the N64's own 59.82 Hz -- the game's clock at the console's speed
    The N64's VI interrupt (what the game counts time by) is locked to HDMI's frame so the picture
    never tears; HDMI ran 640 x 480 at 25.000 MHz, 59.52 Hz, so every game ran 0.5% slow against a
    real NTSC N64 (3094 VI clocks x 263 lines at 48.681812 MHz = 59.826 Hz).
    N64 builds give HDMI its own MMCM: 50 / 2 x 25.125 = 628.125 MHz, /25 = 25.125 MHz (59.821 Hz),
    /5 for the serialisers. HDMI audio paced and regenerated for it (44.1 kHz: N 9408, CTS 41875;
    48 kHz: N 6144, CTS 25125); the VI's half-line is one 31.84 us HDMI line. Other consoles keep
    the shared 25 MHz clock. Board: VI interrupts 59.84 a second (were 59.57)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
2026-10-11 PS1: CPU and GPU run ahead of the console's pace by default; non-debug images drop the debug reads
    - console_top: cpu_pace = 0, gpu_fast = 1 at reset (ctrl 0xEC bits 12/13). Held to the console's
    pace, every DDR3 wait our GPU has (the console's VRAM had none) made frames late. Syphon Filter's
    first level, the same spot each run: paced 17.9 / 15.3 / 11.2 fps, CPU unpaced 18.4 / 16.6 /
    15.9, GPU unpaced 19.2 / 17.3 / 16.6, both 19.5 / 18.2 / 19.7, and 19.8 steady in play
    (DuckStation 20.0). Games still wait for their vblanks: they stop missing them, nothing runs
    fast. tools/ps1/ps1suite.py writes 0xEC = PACE (0x19000) for the timing tests, as before.
    - PS1_DBG=0 images read none of t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
2026-10-11 PS1: MFC0/MFC2/CFC2 go through the load delay slot -- Tekken 2's fighters were fans of spikes
    On the R3000 a move from a coprocessor is a load: its value reaches the register one
    instruction late (DuckStation: WriteRegDelayed for all three). Ours wrote it at once.
    Tekken 2's fighter loop puts `mfc2 t0,SZ1` in a branch's delay slot and `mtc2 t0,VXY0`
    at the target, which must still send the vertex t0 was loaded with; we sent SZ1, and
    nine polygons in ten had a corner hundreds of pixels away (found with the GTE
    snapshot: VXY0 equal to SZ1 bit for bit in every bad RTPT).
    - r3000: exec's coprocessor reads call wdly; S_EXEC puts the value where a load whose
    word has just arrived goes (ld_commi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
2026-10-11 README: the front page as it stands -- six consoles, the SNES, measured PS1/N64 speeds, no LAN
    Rewritten for people meeting the project for the first time: what it is and why
    hardware, what each console plays today (checked against the tree: the NES mappers
    are NROM/MMC1/UxROM/MMC3, not the six the old page listed), how it is verified, the
    parts, the known gaps, and a place for the coming Patreon. Fresh menu pictures from
    tools/menu_preview. The guide no longer asks for the LAN8720: the consoles have run
    from the board's own oscillator since 2026-10-06.
2026-10-12 NES: the audio sample registered -- the sweep-to-filter path passed by 0.003 ns
    The sweep units, the channel outputs, the non-linear mixer's tables and the HDMI audio
    filter's multiplier formed one 19.7 ns path at 50 MHz; the 2026-10-12 builds passed by
    0.067 and 0.003 ns. A register on nes.v's audio output splits it; a sample 20 ns late is
    no sample late. tb_apu and tb_nes pass.
2026-10-12 ESP32: no Wi-Fi, no web server -- Bluetooth pads lost and delayed buttons beside them
    On the T8 Wi-Fi shares the one radio and the internal RAM with Bluetooth, and loop() served
    the web page before it polled the pads: with a DualShock 4 in, buttons arrived late, stuck or
    not at all. Removed: the access point, the station join, the page and its /api (installs,
    uploads, disc fetch and verify over HTTP), the menu's Wi-Fi, keyboard and QR pages, and the
    PC tools that drove the API (console_ui.py, sdcore.sh, rangeserve.py). console.ino is 970
    lines, from 1,939; the image 878 kB. Cores and games go onto the card in a PC; a core is
    installed by picking a game of that console in the menu, or `instal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
2026-10-12 ESP32: a pad's word goes ahead of the disc on the link
    The disc task sends sector after sector and the XA task its chunks, each holding the SPI link
    for a millisecond or two and taking it again at once; the pads' write, from loop() at the
    lowest priority on the other core, queued behind a run of them. padWrite raises a flag and
    every bulk transfer (a sector, an XA chunk, a flash page, a block read) steps aside before it
    takes the lock, so a button waits for the one transfer in flight and no more. The XA chunk
    is 512 words (1.6 ms) instead of 1024.
2026-10-12 Menu: a PlayStation disc with several tracks is one entry, named after its cue sheet
    Every .bin under /roms/ps1 was a game, so Tekken 2 and MediEvil showed once per track. The
    cue sheet is the game now: one entry with the cue's name, playing its first FILE (the data
    track), and the track files a cue names are not listed on their own. A .bin without a cue is
    listed as before.
2026-10-12 ESP32: a disc's audio tracks from the card -- the cue sheet laid out, the drive told its tracks
    The drive was fed one image file, so a disc with CD audio (Tekken 2, MediEvil: tracks 2 and
    up) had no music. discInsert takes the .cue now and lays the disc out as pc/cdaudio.py did:
    the FILEs end to end, each track from its INDEX 01, the INDEX 00 gap kept, a PREGAP as
    silence; the card reader reads inside one segment at a time from whichever file holds it.
    The table of contents goes to ps1_cdrom.v (console 0x5000 + 4 * entry) on insert and again
    whenever the drive is told the disc is in after a reset, so GetTN / GetTD / Play know the
    tracks; the audio sectors reach the drive like any other. The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
2026-10-12 ESP32: quiet -- the firmware's own chatter off unless "log on" is typed
    Every "disc: ...", "menu: ...", "pads: ..." line went out on the UART as it happened, and
    Serial.print blocks once its buffer is full: time taken from loop(), which is the pads.
    log.h: a Log that prints only when switched on over serial (not kept across a reset). The
    replies to serial commands (the register reads pc/pad.py relays, state, install) still go
    through Serial: they are answers, not logging.
2026-10-12 pad.py: a controller on the PC is relayed only with --relay -- a DualShock left plugged in sent MediEvil a held L2
2026-10-13 PS1 raster: texture prefetch -- the scanner runs ahead, missing tiles fetched on a port of their own
    Every texel miss was found only when its pair reached stage C, and cost the whole round trip
    with the pipeline stopped: on the board (MediEvil, texstall.py) 1.56 M fetches of 41 clocks in
    ten seconds, 13% of all clocks; in tb_ps1_clut COLD1 LAT40 (a 256 x 256 texture, every triangle
    elsewhere on it, the board's latency) 66% of the engine's time.
    The scanner now runs up to 32 pairs ahead into a queue (Q) and a pair's texel lines are looked
    up as it goes in; a missing line's tile (the aligned pair of lines and the pair below, the video
    cache's run) goes out as four line reads on pf_m_*, a seve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
2026-10-13 Game Gear core, and RELEASE images
    The Game Gear is the Master System core with GG set (sms.v): the 12-bit palette
    written as two bytes (vdp.v color12), START read at port 00h, ports 01h-05h as a
    Gear with nothing on its EXT port, the PSG's stereo mask at port 06h (psg.v gives
    the two sides). The console cuts the LCD's 160 x 144 out of the picture and
    frame_hdmi triples it (FMT 4, SCALE 3) to 480 x 432. Console 6, core id 'G',
    tools/core.sh gg; the menu lists it as "Game Gear" (.gg, folder gg) with its own
    pad layout. tb_gg checks the palette, the ports and the mask.
    RELEASE=1 (tools/core.sh) builds the shipping image: no logic analyser, no PC
    sound ring, no frame reader, no bare-CPU test s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
2026-10-13 Master System pads in the core's order, PAUSE wired; files onto the card over the link
    The firmware listed the Master System's buttons in the NES's order, which put Up on
    Button 1 and Button 1 on Up; the layout now follows port DCh (up, down, left, right,
    button 1, button 2) and PAUSE, which was never connected, is the Z80's NMI (joy1 bit 7).
    "U open <path> <size>" / "U <base64>" / "U close" on the ESP32's serial console write a
    file onto the SD card while it sits in the board (tools/sdput.py through pc/pad.py's tool
    port): a homebrew ROM, a core. The card no longer has to come out for that.
    RELEASE: the cartridge's core-write port is left out with the bare Z80 (Vivado would not
    infer the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
2026-10-13 Game Boy: the SM83 processor, passing all 500,000 SingleStepTests
    rtl/gb_cpu.v is the DMG's CPU written from the opcode tables: every opcode
    including the CB set, HALT with its bug, STOP as HALT plus a DIV-reset pulse,
    EI's one-instruction delay, and the five-cycle interrupt dispatch that picks
    its vector after the high byte of PC is pushed. One state per M-cycle, so the
    cycle counts are the official ones by construction.
    sim/tb_gb_cpu.v runs the whole SingleStepTests sm83 suite in one xsim session
    (tools/gb/sm83tests.py turns the 161 MB of JSON into a hex stream the bench
    pulls with $fscanf): registers in, 64 kB of flat RAM, every M-cycle's bus
    activity compared, and the instruction has to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
2026-10-13 PS1 raster: the row starts near the shape, and the engine sets up the next primitive while it draws
    Measured on MediEvil's own drawing (the board's GP0 trace, replayed in tb_ps1_replay): a
    quarter of the raster's clocks were pairs with nothing in them, most of them walked from the
    box's left edge to the shape on every row; and the engine spent its setup between primitives
    with the raster idle.
    - Row start: the next row starts 4 pixels (16 after a miss) left of this row's first inside
    pair, from the edge and interpolant values kept there -- exact, because the pair jumped to
    must be outside by an edge whose inside lies to its right; otherwise the row restarts at the
    box's left.
    - Overla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
2026-10-13 Atari 2600: TIA, RIOT, console top, a gate kernel and its bench
    cpu6502 gets an RDY input behind HAS_RDY (default 0, so the NES is the same
    sequencer it was; tb_nes 01-basics still passes). Low RDY holds read cycles
    only, as the NMOS part does -- the STA WSYNC that drops it must complete.
    a26_tia: the 228-clock line, VSYNC/VBLANK/WSYNC/RSYNC, playfield with
    reflect/score/priority, two players (NUSIZ copies and sizes, reflect), two
    missiles, ball, VDELP0/1/VDELBL, RESMPx, HMOVE with its 8-pixel bar, all 15
    collision latches, INPT0-5 with the VBLANK latch/dump bits, and the two audio
    channels as signed 16-bit.
    a26_riot: 128 B RAM, the timer (1/8/64/1024T, INTIM, the flag and the
    one-a-cycle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
2026-10-13 gb_cpu: writes land in the third T-cycle, and the T-cycle is an output
    A write to IF that requests an interrupt has to be seen by the instruction
    boundary right after it. Committed on the fourth T-cycle, together with the
    step that samples the interrupt lines, it was one M-cycle late, and blargg's
    02-interrupts printed "EI Failed": the handler ran one instruction late. The
    real part writes mid-cycle too. All 500,000 SingleStepTests still pass.
    tcyc is exported so the machine can stall on the last T-cycle only.
2026-10-13 Game Boy: the machine -- PPU, APU, timer, mappers -- passing blargg and dmg-acid2
    rtl/gb_top.v is the DMG around the SM83: the memory map, 8 kB work RAM, high
    RAM, joypad, the DIV-based timer (falling-edge ticks, the delayed TMA reload),
    a serial port with nobody on the other end, OAM DMA, and the cartridge: ROM
    through a request/acknowledge port so it can live in DDR3, mapper chosen from
    the header (none, MBC1, MBC3 with its clock, MBC5), 32 kB of cartridge RAM
    with a read port and a dirty flag for saves. No boot ROM: the post-boot state.
    One clock domain: a phase accumulator makes the 4.194304 MHz T-cycle from the
    system clock, and a slow ROM byte withholds it from everything at once.
    rtl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
2026-10-13 Atari 2600: RIOT timer per the 6532 datasheet, bank-switching gate, homebrew runs
    RIOT timer: the datasheet's worked example (52 at /8: 51 the next cycle,
    "52-26-1", the interrupt at pulse 416, "(52 x 8) + 1 = 417T") means the count
    steps once on the cycle after the write and then every interval. It held N for
    the first interval -- one interval late -- and the gate's expected values had
    been worked from the RTL, not the datasheet. Both fixed; a read in the cycle
    the flag sets no longer clears it. The Pipes 2600 homebrew's own timer
    arithmetic now gives exactly 262 lines a frame (264 before).
    cpu6502: UNDOC_IMM (default 0, so the NES decodes what it always did) adds the
    stable undocumented i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
2026-10-13 Game Boy and Atari 2600 in the board image: console_top, HDMI, sound, core.sh
    Game Boy (console 7, core id 'B', tools/core.sh gb): gb_top with its cartridge in DDR3
    through cart_ddr3 and cart_cache, as the SNES's; the byte port answered from the cached
    16-bit word, the address's low bit picking the half. The cache resets with the core so a
    new cartridge never answers from the last one's lines. Picture: 160 x 144 shades through
    frame_hdmi FMT 5 (DMG greens), tripled to 480 x 432. Sound: its two sides into audio_lr.
    No battery saves yet (gb_top's sav_* port is left for the loader).
    Atari 2600 (console 8, core id 'A', tools/core.sh a26): a26_top with its cartridge in its
    own block RAM, filled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
2026-10-13 PS1 processor cache: stores claim lines without a fetch, and a stream buffer reads ahead
    Measured first, on a real game: tools/ps1/memtrace.py runs Syphon Filter's code out of a
    DuckStation savestate (RAM, registers, scratchpad, GTE) with the hardware around it reduced
    to what keeps the game's loop turning, and writes every fetch, load, store and DMA word;
    tools/ps1/cachemodel.py replays that through the core's cache hierarchy and alternatives.
    The processor waits on memory for about 35% of its instructions there (the board measured
    26% of all clocks in MediEvil), and it is the 128 KB L2's misses that cost it -- bigger
    L1s buy 2-6%. Of the alternatives that fit the chip:
    stores that miss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
2026-10-13 Game Gear: red and blue the right way round
    The Game Gear's palette word is BBBBGGGGRRRR, and frame_hdmi's FMT 4 put its top nibble
    (blue) into the red byte. Caught by the Game Boy / Atari integration's review.
2026-10-13 Docs: Game Gear, Game Boy and Atari 2600; release images; files onto the card over USB
2026-10-13 core.sh: the router's mid-run timing warning is not fatal when the final slack passes
    build.tcl's recovery passes run after the router has already printed "did not meet timing"
    (Route 35-39); the TIMING line is the verdict on the finished design. The PlayStation's
    release image passed at +0.004 ns and was being thrown away for the earlier warning.
2026-10-19 Docs: a proper README, current development guide and roadmap
    The README rewritten: a screenshot grid captured from the running board, a systems table
    with status, hardware, getting started, building, layout, documentation index,
    verification, acknowledgements and licence. DEVELOPMENT.md describes the USB/ESP32
    setup and board tools in place of the old network setup; ROADMAP.md is per system.
    GUIDE.md covers DOS games; CONSOLES.md every system. THIRD_PARTY.md lists every outside
    component and its licence; the Cult-of-GBA BIOS's MIT notice is in rtl/LICENSE-gba-bios.
    The menu screenshots list homebrew instead of a commercial library.
2026-10-20 SiSTer: the open-source release
    New systems: Game Boy Advance (ARM7TDMI, picture, sound, RTC), PC Engine (HuC6280, VDC, VCE,
    PSG), Game Boy Color, Game Gear fixes, and a DOS PC (ao486 with Sound Blaster 16, OPL3, SVGA,
    an ATAPI CD-ROM and IDE disks served from the SD card).
    The graphical menu composed by the FPGA, the ESP32's quad link, per-game PC controller maps,
    the picture grabber and board test tools, and the licence: GPL-3.0, with third-party parts
    listed in docs/THIRD_PARTY.md.
2026-10-20 Ko-fi: the Sponsor button and a support section
2026-10-21 DOS PC: 66.7 MHz (was 62.5) -- ao486's critical paths restructured, cycle-exact
    The decode, read and write stages' late stall, reset and fault terms are now selected last
    instead of steering whole cones; TLB/L2 region checks travel with the address; carry-save
    effective-address sums. Every change is marked "(SiSTer: ...)" with its equivalence argument.
    Gate: sim/pc's per-clock trace hash (CPU bus, I/O, DMA, interrupts, CS:EIP) is identical to the
    untouched RTL through FreeDOS (252 M clocks) and Doom's title and demo (2.29 G clocks).
    Board: Doom 1.9 -timedemo demo3 16.6 fps (15.6 at 62.5 MHz). core.sh's PC default is PC_DIV 15.
2026-10-21 Saves: Game Boy battery RAM and the MBC3 clock; GBA EEPROM, flash fixes; a lost cartridge word
    Game Boy: the cartridge RAM gets a host port (as the SNES's), MBC3's clock is readable and
    presettable; the menu keeps /saves/gb/<game>.sav (RAM + the BGB/VBA-M 48-byte clock trailer,
    the clock moved on by the time the game was off), written when it changed.
    GBA: EEPROM (512 B / 8 kB) is new; the save type comes from the library string in the ROM, so
    64 kB-flash games see their own chip ID; chip erase cleared one bank of two; .sav files at the
    emulators' sizes.
    cart_ddr3: a line write the DDR3 held off longer than a word interval cleared the buffer after
    the next line's words had arrived -- a rando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
2026-10-22 Bluetooth without BTstack: an ESP-IDF Bluedroid backend (opt-in), working with a DualShock 4
    BTstack's licence rules out selling the console, so pads_bluedroid.h is a Classic HID host of
    our own on Bluedroid's L2CAP plus esp_hidh for BLE Xbox pads, built on the stock esp32:esp32
    3.3.11 platform (ESP-IDF 5.5.5); pads.h picks the backend. DualShock 4, DualSense, Switch Pro,
    Xbox: pairing, reconnect, two players, PS/Home, rumble. tools/bt_abi/check.sh checks our copy of
    Bluedroid's internals against the platform's sources.
    On the board: the whole firmware on IDF 5 (link, cartridges, a PS1 disc + XA, a DOS game), a
    DS4 pairs and plays; ~10.5 kB internal RAM free at worst during Doom. Links are k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
2026-10-22 DOS games: TTD starts in 24 s, not 5 minutes -- drop MicroProse's FILES.TMP on import
    Transport Tycoon Deluxe's CD install keeps FILES.TMP, the files it copied from the CD on its
    last start; every start deletes them and copies 6.7 MB again (13,000 sectors through the SD
    card). The pack already holds the files, so addgame.py drops the list when everything in it is
    present. On the board: 24 s to the game and 59 sectors written, music playing.
    Firmware: mv <from>|<to> renames or moves a file on the card (the folder made if need be).
2026-10-22 N64: every RDP mode the model has -- YUV, convert, TEXEL1, noise, LOAD_TLUT; Smash Bros. runs
    YUV textures (load split, chroma/luma filtered apart), the SET_CONVERT stage and convert_one,
    one-cycle TEXEL1 as the next pixel's TEXEL0, the combiner's noise and the noise dithers,
    LOAD_TLUT from 8/32-bit images, an interlaced scissor's dither, 4-bit colour images.
    Gates: krom's RDP tests through the RTL 127/127 (was 113), tools/n64/rdpmodes.py 35 cases
    against the model. Build: RELEASE=1 AREA=1 EFFORT=1 at 62.5 MHz, +0.025 ns, 87.5% LUTs.
    On the board: Super Mario 64, Mario Kart 64 and Super Smash Bros. (which did not boot before).
2026-10-22 DOS PC: 71.4 MHz (was 66.7) -- more cycle-exact restructuring and a floorplan
    ES/SS/CS limits and bounds registered beside the segment caches; the stall chain split so its
    late inputs meet only the last gate; the TLB written as the 8-entry direct-mapped table it
    always was (its fill only ever wrote way 0), outputs per hit/miss; parallel segment-base sums;
    a carry-free FIFO read pointer. Each change is marked "(SiSTer: ...)" with its argument.
    boards/qmtech_a100t/pc_floorplan.xdc (PC only) holds the 486 and its L2 in the lower 110 rows:
    0.3-0.45 ns on the same netlists. Timing +0.008 ns setup, +0.030 ns hold.
    Gates: sim/pc's per-clock trace hash identical to the untouched RTL through FreeDOS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
2026-10-22 Repo tidy: the Ethernet-era host tools go; pc/ folded into tools/; a stray image into docs/images
    The board has no network (removed for good), so everything that only worked over it is gone:
    web/ (the browser debugger), pc/server.py, fpgalink.py, mock_fpga.py, synth.py, shell.py,
    local.env.example, docs/PROTOCOL.md (the UDP register protocol), tools/serve.sh, playtest.py,
    shellscope.py, uicheck.js, and 40 board scripts in tools/ps1, tools/n64 and tools/sms that read
    the board through that server.
    What still works moved: pc/pad.py -> tools/pad.py (the ESP32 serial bridge every board tool
    uses), pc/cdaudio.py -> tools/ps1/, pc/n64_saves.py -> tools/n64/; references updated.
    docs/ps1_boot.png -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
2026-10-22 Docs: every page checked against the code; the network-era plans rewritten as the console is
    ARCHITECTURE.md now describes the flash layout (shell + two slots), the card, the quad link and
    its commands, how a system and a game are loaded, and why the board cannot be bricked. SHELL.md,
    esp32/README.md (all 12 systems' card layout, both firmware builds, the serial commands),
    PLAYSTATION.md (discs, XA and the memory card from the ESP32), MEGADRIVE.md and N64.md describe
    the cores as they are, without development diaries. Corrections: the NES has mappers 0, 1, 2, 4
    (3 and 7 were claimed, not built); Game Boy saves; link speed; links and paths that pointed at
    deleted files. Every link, image and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
2026-11-02 Everything our own, step one: Bluedroid is the only Bluetooth; the third-party PC is removed
    - pads.h: the Bluepad32/BTstack path is gone; our HID host on ESP-IDF Bluedroid is the default
    and only stack (firmware compiles on stock esp32:esp32 3.3.x: 1,476,806 B).
    - rtl/pc (ao486, 486Tang, MiSTer L2/IDE/SB16, OPL3), pc_top.v, the floorplan, sim/pc and
    tools/pc/pccfg.py removed; a new PC of our own goes in rtl/pc, read whole by build.tcl.
    - pc.h: left-stick directions as buttons in .pad files, mouse_y = off.
    - Docs, release.sh and THIRD_PARTY.md brought up to date.
2026-11-02 Menu: our own console art, built in; favourites; SiSTer branding
    - tools/menu/mkart.py draws every console's name plate (its name in the menu's typeface) and
    a drawing of its controller or handheld, and writes them into esp32/console/gfx_art.h; gfx.h
    falls back to these when the card has no /menu/logos. RetroPie's theme art and mklogos.py,
    which fetched it, are gone. Firmware: 1,705,322 B.
    - Favourites: square in a console's list marks a game; favourites sort first with a gold
    badge; kept in /saves/favourites.txt.
    - SiSTer on the home title, the splash and About; clearer settings hints.
    - docs/images: the menu screenshots redrawn from the firmware's own screens (gfx_preview).
    Co-Aut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
