Vygis1/sister/(notices)

Notices in the files:
README.md:
License: GPL v3
